GavynDracula/GyreNano/pcb/keyfield-fpc/README.zh-CN.md

# FPC 键区 — V27

[English](README.md)

一款通用半边板，左手 18 键；右手去掉/不装 T_SW1、T_D1，使用 17 键。尺寸 **97.176 × 96.472 mm**，双层 **0.11 mm PI、1/3 oz 铜**，每侧六根键区 FFC，复用现有 holder。

[已提交试样 ZIP](fabrication/GyreNanoKeyfieldFPCV27-SampleED.zip) · [KiCad 工程](kicad/GyreNanoKeyfieldFPCV27.kicad_pro) · [工艺说明](SAMPLE-FABRICATION.txt) · [采购 BOM](BOM.zh-CN.md)

试样采用无胶电解铜、黄色覆盖膜、沉金 1 µin、不做厂家补强。这是用于折弯/装配验证的试样配置，不代表已验证可靠性。JP1 左手只焊 1–2，右手只焊 2–3；不得两侧同时焊接。

此前试样说明中的独立 FR4 背衬方案保留；另有 [FPC 直接承托打印件](../../models/fpc-supports/README.md) 可试验，不能未经检查把两种承托叠加。实际焊接、折弯、热插拔承力和排线安装仍待实物验证。
