GavynDracula/GyreNano/models/integrated-fr4/README.md

# Integrated shells and FR4 retainers

Unchanged V14 upper shells and main retainers; original V8 thumb retainers. All files retain their historical assembly coordinates, in mm. Orient the STL in your slicer; the integrated STL files are not newly bed-oriented. Reuse the [V7 bottom trays](../3x5/).

| Part | Left | Right |
| --- | --- | --- |
| Upper shell | [STL](left-shell.stl) | [STL](right-shell.stl) |
| Main retainer | [STL](left_retainer.stl), [STEP](left_retainer.step) | [STL](right_retainer.stl), [STEP](right_retainer.step) |
| Thumb retainer | [STL](left_thumb_retainer.stl), [STEP](left_thumb_retainer.step) | [STL](right_thumb_retainer.stl), [STEP](right_thumb_retainer.step) |

These mounts/retainers are the existing 0.6 mm FR4 baseline. No 0.4 mm fit adaptation is included. [Static checks](checks/) are retained; no new geometry or slicing was performed during cleanup. The modeled M2 × 4 mm screw/head envelope is a trial assumption, not a qualified fastener selection. Fasten the right thumb retainer before arranging crossing ribbons.

For the bare-FPC route, keep these upper shells and replace all four retainers with [FPC supports](../fpc-supports/README.md).

中文：左右上壳、主区承托、拇指承托按一套选取；这里是原有 0.6 mm FR4 配合，不包含 0.4 mm 改型。STL 为装配坐标，切片时自行摆放，实际螺丝与打印间隙待试装。
