GavynDracula/GyreNano/pcb/keyfield-fr4/alternative-isolated/README.md

# FR4 V32 — retained isolated-region alternative

99.700 × 99.804 mm, two-layer **0.6 mm FR4 / 1 oz**. Five columns plus separate left/right thumb regions have copper-free mechanical joining tabs. There are no cross-region electrical connections.

[KiCad project](kicad/GyreNanoKeyfieldFR4V32.kicad_pro) · [unchanged fabrication ZIP](fabrication/GyreNanoKeyfieldFR4V32-Gerber.zip) · [checks](checks/) · [current V33](../README.md)

This earlier alternative is retained at the user's request. Vendor panel fees/classification and physical forming remain unresolved. Use C0–C4 plus the appropriate thumb region, with six FFCs per hand. Do not confuse this ZIP with V33.

中文版：这是用户要求保留的 V32 备选，区域间没有电路互联，0.6 mm；与 V33 分开放置，避免下单时混淆。材料折弯与实装仍待验证。
