GavynDracula/GyreNano/docs/firmware.md

# Firmware / 固件

TBD. ZMK is the intended firmware. The existing personal configuration has not
been copied into this repository; no ready-to-flash firmware is included.

待补充。采用 ZMK；现有个人配置尚未迁入本仓库，目前没有可直接刷写的固件。
