GavynDracula/GyreNano/docs/images/gyre-nano.png

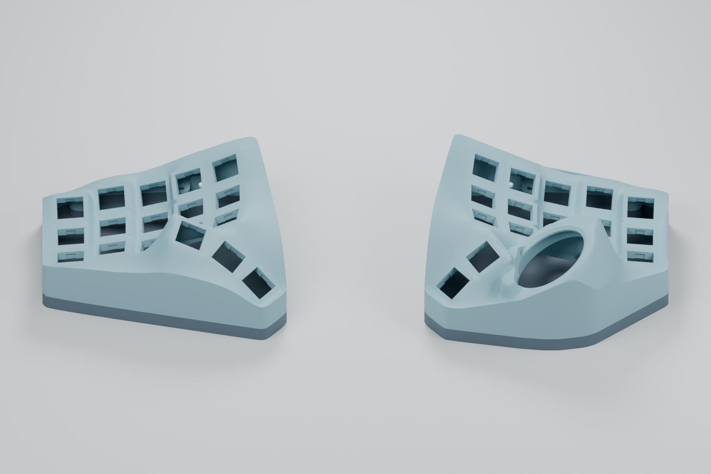
docs/images/gyre-nano.png
