GavynDracula/GyreNano/models/integrated-fr4/images/left-integrated-shell.png

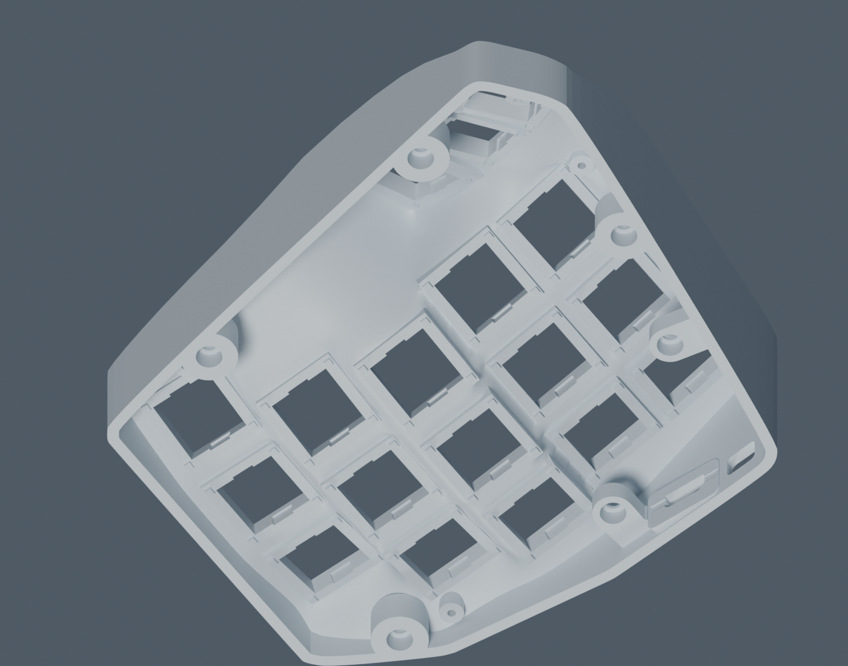
models/integrated-fr4/images/left-integrated-shell.png
