GavynDracula/GyreNano/models/integrated-fr4/images/right-integrated-shell.png

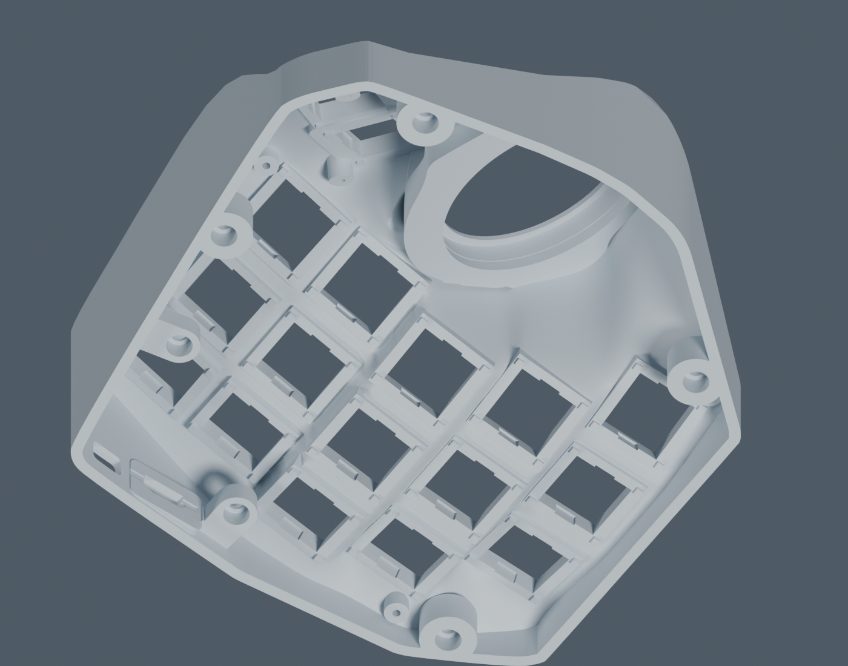
models/integrated-fr4/images/right-integrated-shell.png
