GavynDracula/GyreNano/models/raised-rim/left-transition-detail.png

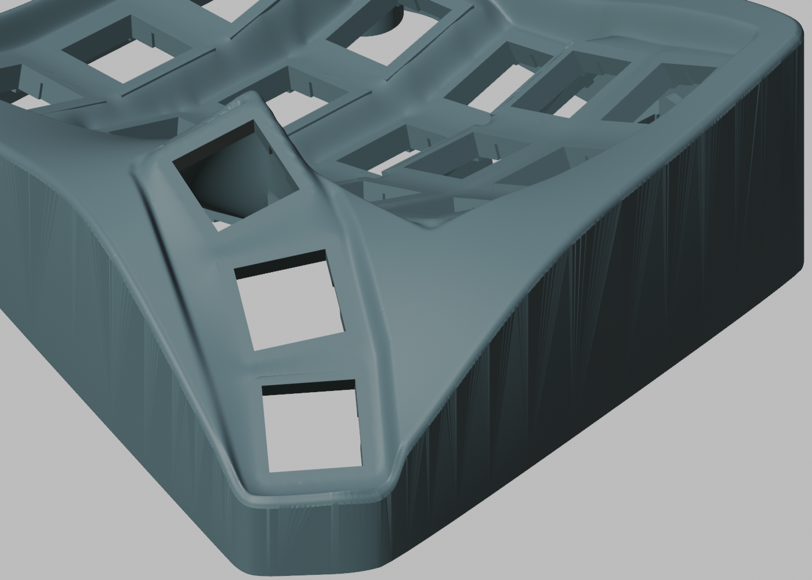
models/raised-rim/left-transition-detail.png
