GavynDracula/GyreNano/models/raised-rim/outer-seam.png

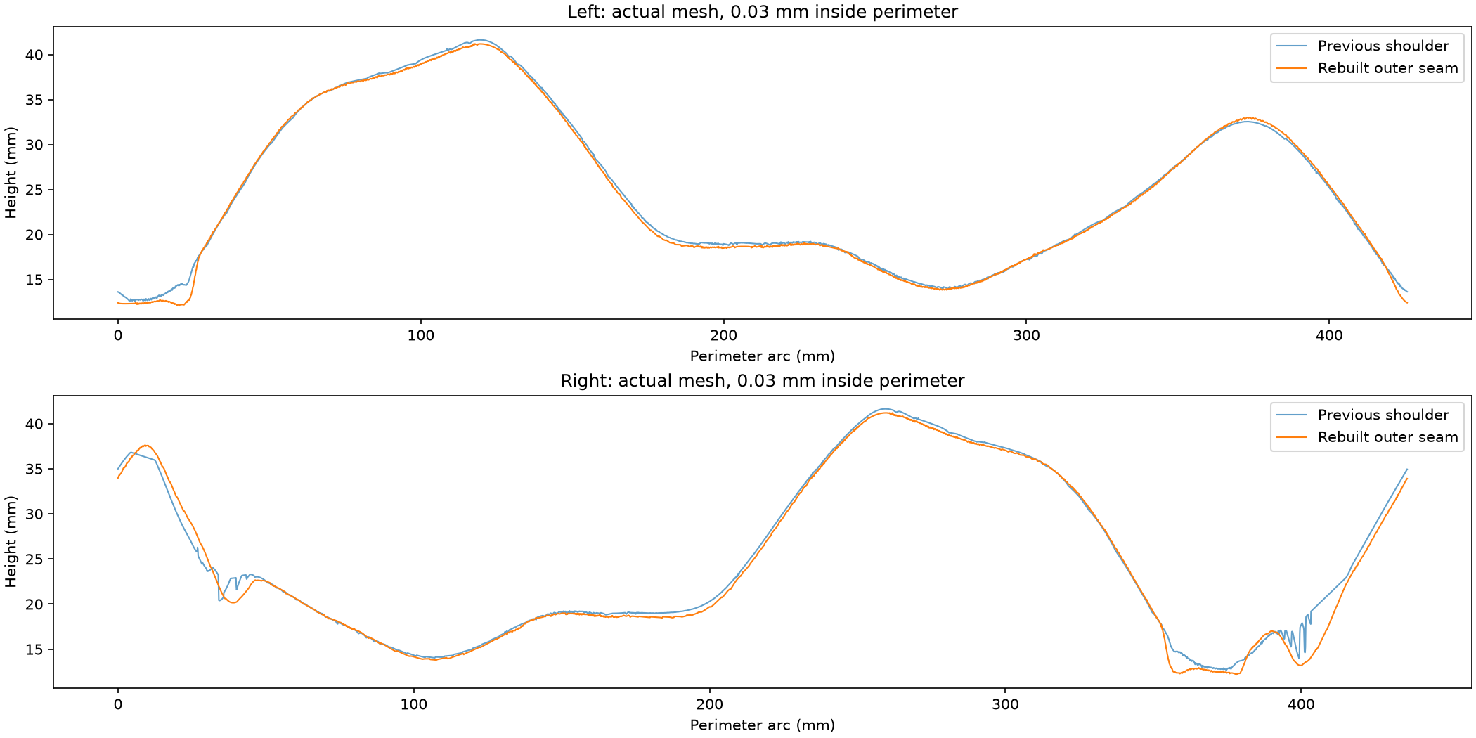
models/raised-rim/outer-seam.png
