GavynDracula/GyreNano/models/raised-rim/right-ball-collar-before.png

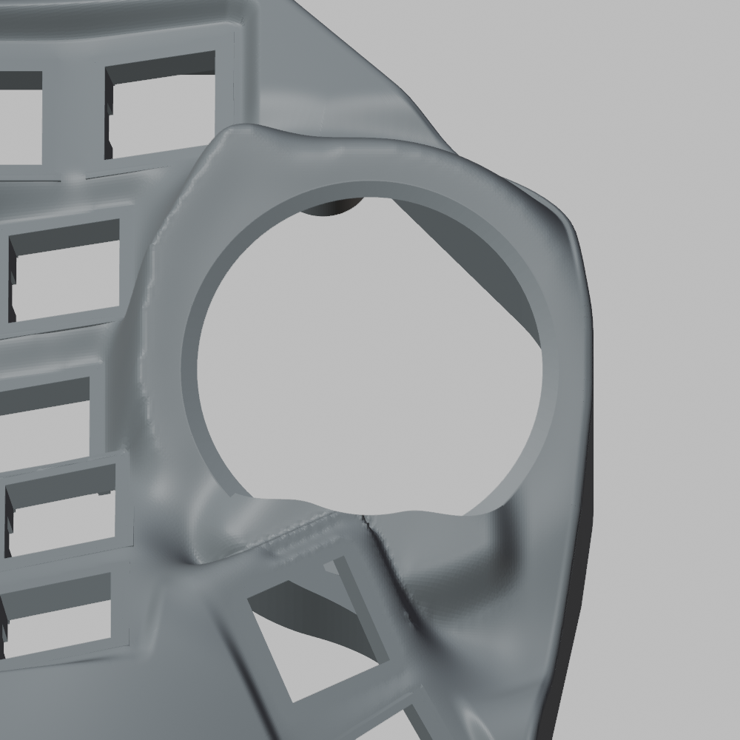
models/raised-rim/right-ball-collar-before.png
