GavynDracula/GyreNano/models/raised-rim/right-outer-seam.png

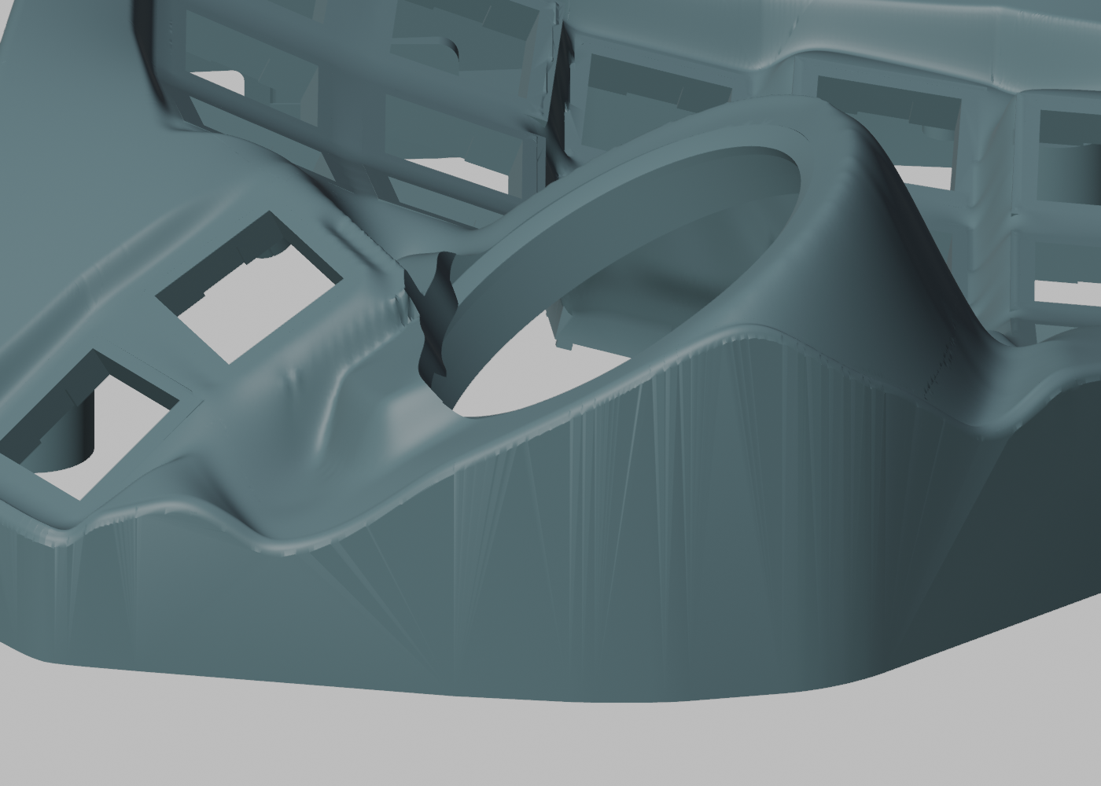
models/raised-rim/right-outer-seam.png
