GavynDracula/GyreNano/models/raised-rim/right-transition-detail.png

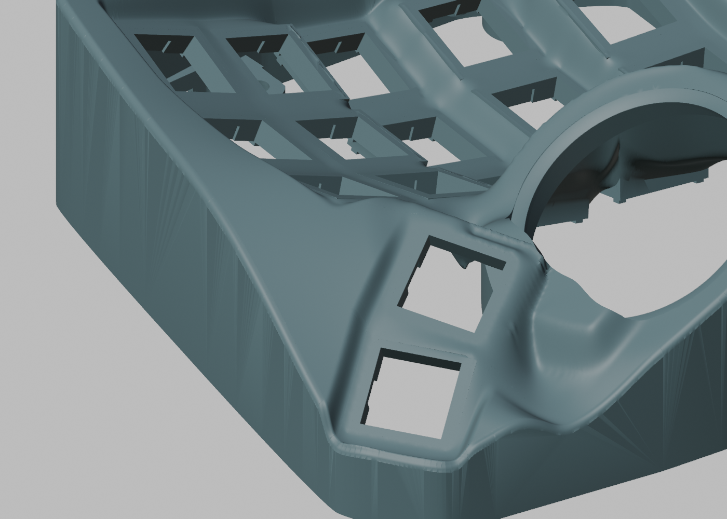
models/raised-rim/right-transition-detail.png
