GavynDracula/GyreNano/models/raised-rim/top.png

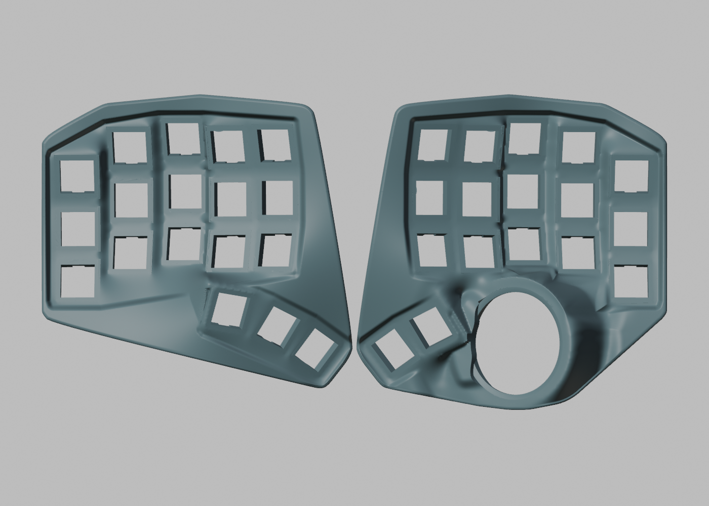
models/raised-rim/top.png
