GavynDracula/GyreNano/models/raised-rim/transition-sections.png

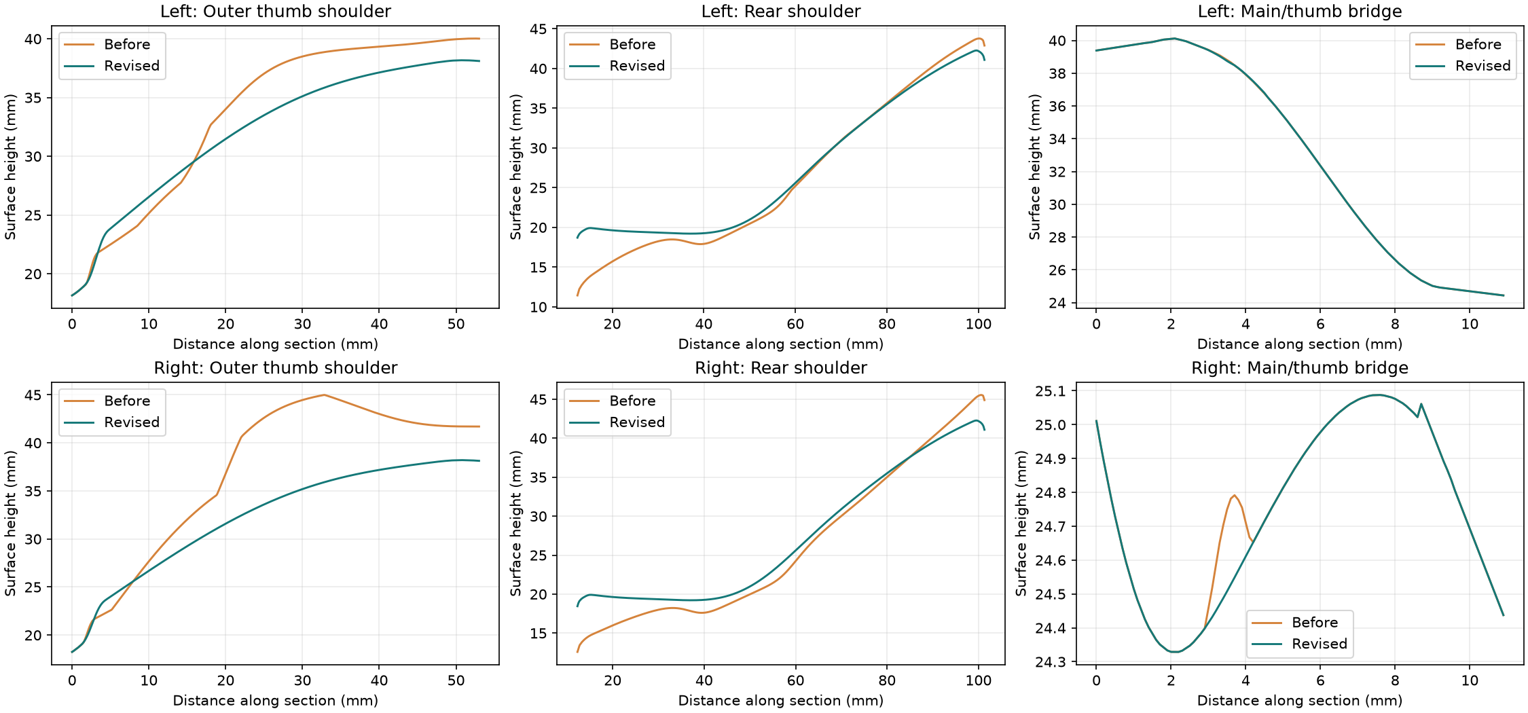
models/raised-rim/transition-sections.png
