GavynDracula/GyreNano/pcb/keyfield-fpc/images/GyreNanoKeyfieldFPCV27-layout.png

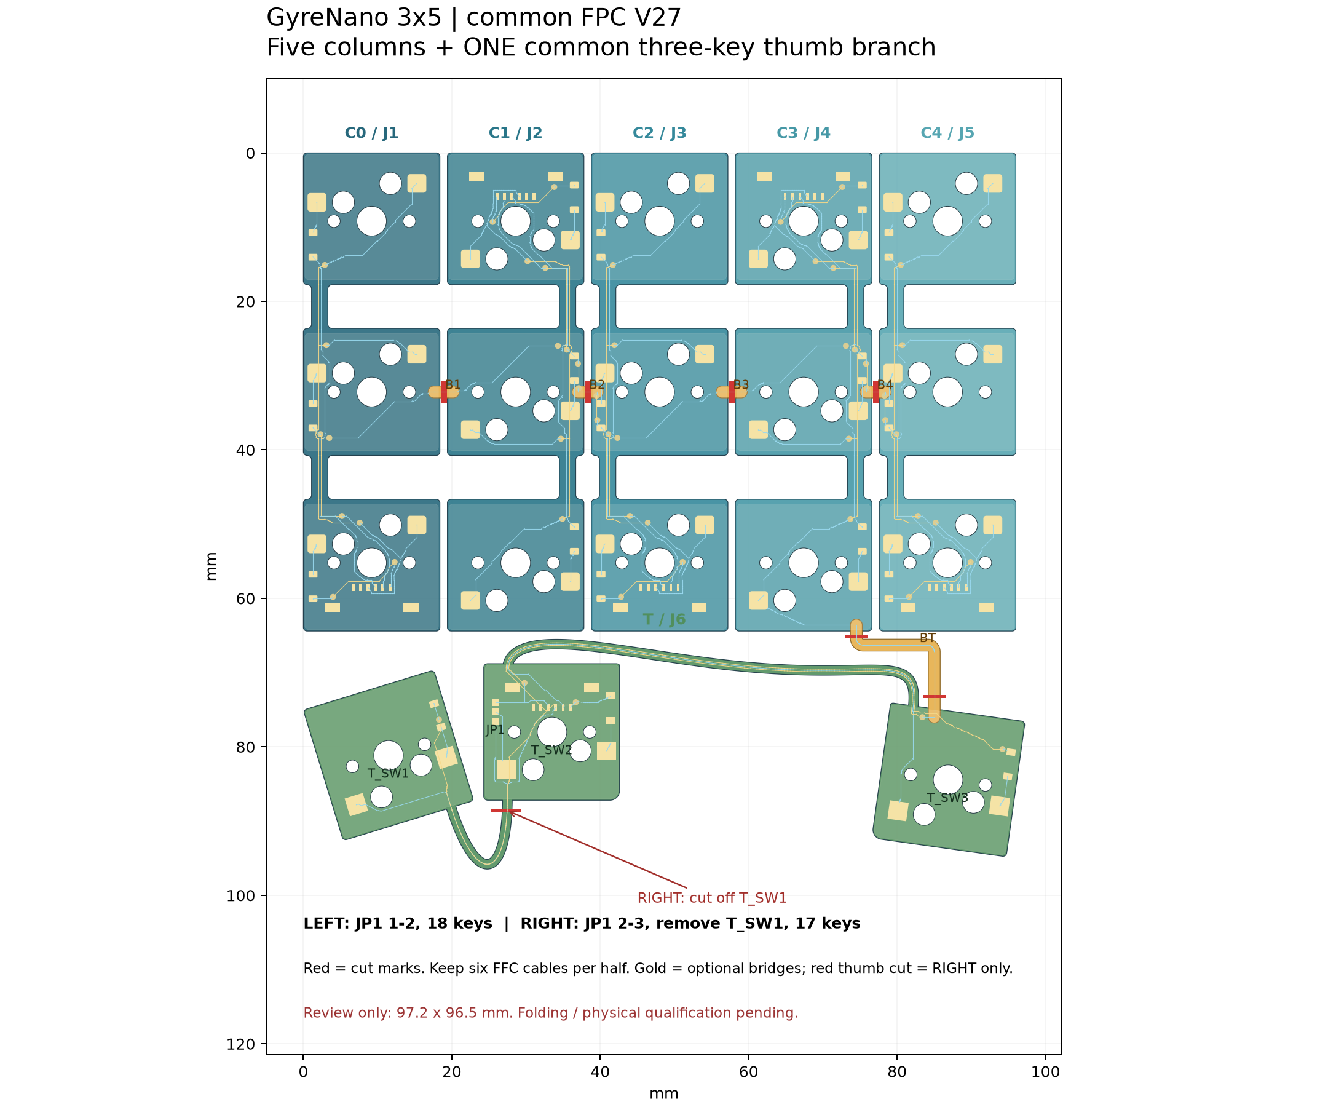
pcb/keyfield-fpc/images/GyreNanoKeyfieldFPCV27-layout.png
