GavynDracula/GyreNano/pcb/keyfield-fpc/images/left-thumb-fold.png

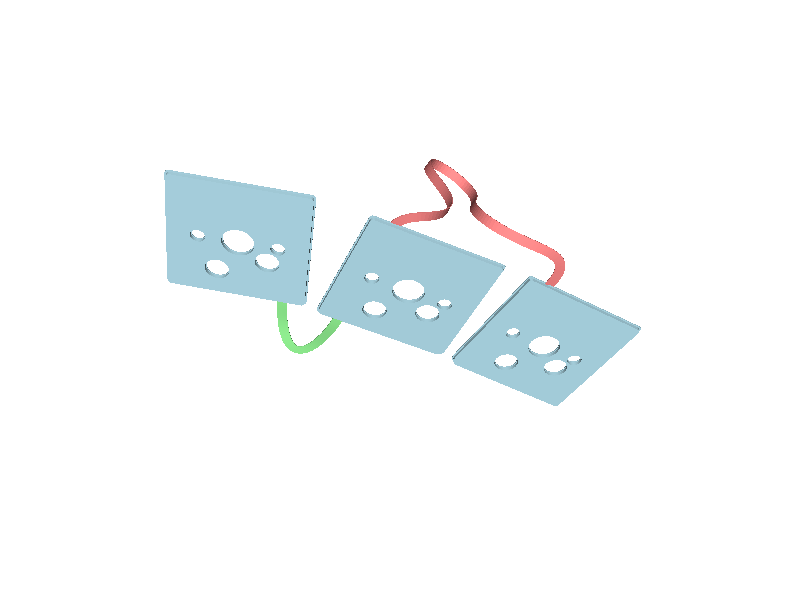
pcb/keyfield-fpc/images/left-thumb-fold.png
