GavynDracula/GyreNano/pcb/keyfield-fpc/images/right-thumb-fold.png

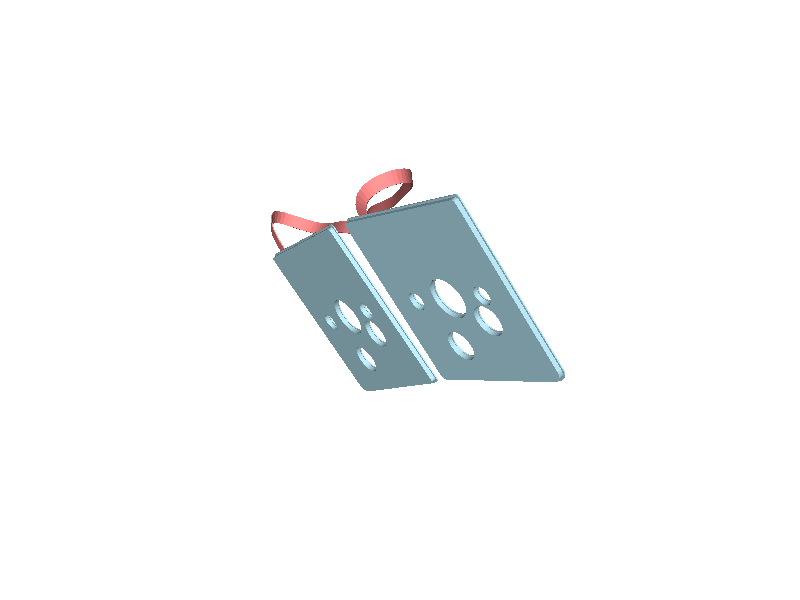
pcb/keyfield-fpc/images/right-thumb-fold.png
