GavynDracula/GyreNano/pcb/keyfield-fr4/eda/preview/GyreNanoKeyfieldEDA.png

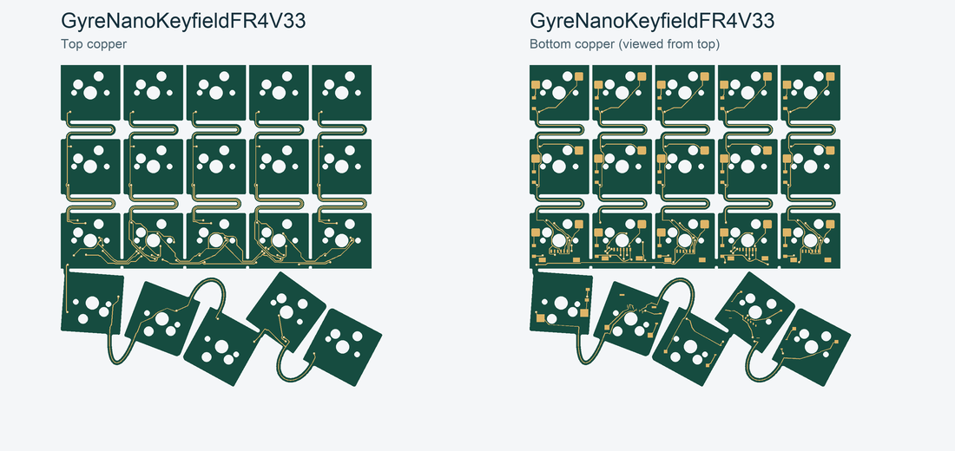
pcb/keyfield-fr4/eda/preview/GyreNanoKeyfieldEDA.png
