GavynDracula/GyreNano/pcb/keyfield-fpc/BOM.zh-CN.md

# GyreNano V27 采购 BOM（2026-11-12）

按**一套左18键＋右17键**计数，不是把此次5张FPC全部焊满。库存尚未知，采购建议是从零备料数量，已有物料自行扣减。用户已提交FPC试样订单，厂家审核结果待定。

来源：V27键区、V12左右holder、V5 sensor原生PCB回读，见[逐件清单及源哈希](checks/bom-native.json)。V22 EDA重建保留这些器件及封装，仅更改开窗/覆铜等；因此对应BOM相同。已打样holder的实际批次尚未回读，本表不代表实物到货检验。推荐采购数量含少量备件；CSV提供“已有/还缺”空栏。

## 先买的核心物料

| 物料 | 型号／规格 | 一套用量 | 建议备料 | 用途 |
|---|---|---:|---:|---|
| MX热插拔座 | Kailh **CPG151101S11-16** | 35 | 40 | 主列30、拇指5；不是Choc轴座 |
| 按键二极管 | **1N4148W-7-F，SOD-123** | 35 | 50或100 | 主列30、拇指5；不要误买SOD-323/直插版 |
| FFC插座 | Molex **2005280060**，6P、1.00mm、卧贴下接触 | 27 | 30 | 两张FPC12＋左右holder14＋新sensor1 |
| 电源拨动开关 | C&K **JS102011SAQN** | 2 | 3 | 每侧holder SW1一个；不要仅按“三脚开关”购买 |
| 电池板端插座 | JST **B2B-PH-SM4-TB**，2P、2.00mm、立式贴片 | 2 | 3 | 两侧holder J8；不是直插PH2.0座 |
| 电池配套线 | PH 2.0、2P配套插头线（PHR-2壳体） | 2 | 2 | 现有电池线若匹配可复用；板端1为正、2为负，实测线序 |

27个FFC插座是完整装配值。左holder J7预留不用，可少焊1个，功能必需26个。若holder已焊好全部插座，则新键区只需12个，另新sensor需1个；复用旧焊线sensor则不装新sensor插座，但需要另做接口转接，不能直接插入旧焊盘。建议保留现用键盘工作状态，优先买新轴座和二极管；反复拆焊旧件可能损伤端子。

FPC原生空板为18轴座＋18二极管＋6插座＋1焊接跳线。右手拆除/不装额外的T_SW1/T_D1后为17键。JP1是PCB焊盘，不买开关、跳线帽或0Ω电阻：左侧只桥接1–2，右侧只桥接2–3，不可同时桥接两边。

## 排线：数量确定，成品采购规格还需试装

共**13根**：左右键区各6根，右侧sensor另1根；左holder J7不用。统一6芯、1.00mm节距，插入端总厚度按Molex图纸 **0.30±0.05mm**；端部露铜、加强片及接点处理也需匹配图纸。不能拿0.11mm键区FPC厚度当成FFC插入端厚度。

目前没有可以无条件照买的13根长度/A-B型清单。V12的[cable-budget.csv](../../docs/cable-budget-reference.csv)是旧路径预算，不是V27实装采购定长；J6整线未定型。可先少量买100/150/250mm的同面与异面样品各1根（共6根）用于辨认接点、测试路径，这些只是试装样品，不保证覆盖整套13根，确认后再补齐。留余长并不意味着任意长线都能收进壳内；不要剪短普通FFC后直接插座使用。

所有键区与sensor要求**板端pin i对应holder pin 7−i**。同面/异面商品的A/B称呼不统一，先按实际插入方向与万用表逐芯确认1↔6、2↔5、3↔4，再接电。插座替代品还需核对焊盘、固定脚、接触面和锁扣占位，不能只按6P/1mm替换。

## 主控与可复用件

| 物料 | 用量 | 采购处理 |
|---|---:|---|
| nrfmicro 1.4 | 2 | 优先复用；nice!nano兼容板不等于全部引脚/电池/充电配置相同，替换前单独核对 |
| 主控排针 | 4条1×12，2.54mm | 两块主控各两排；优先沿用现有安装高度。若用可拔插排母还需4条匹配排母，型号/高度暂不冻结 |
| MX轴、键帽 | 各35 | 复用现有 |
| 电池 | 2 | 复用现有；尺寸/容量尚未记录，不据此推荐新电池 |
| 34mm球、原适配器/轴承/镜片组件 | 各一套 | 复用原配套，保持传感器光学组合 |
| 安装螺丝 | 按现有托架/壳体 | 长度、螺帽及主控堆叠仍需实装，不给未验证的统一长度 |

## 只有重焊新sensor时才采购

现用sensor已经工作正常，可以先保留。若装新FFC sensor板，下表为当前旧版1.9V电路的物料，**不要混用网上bom-fix版的1.8V稳压器/C4值**。旧工程LCSC编号有错配记录，本清单不沿用这些编号；电容按容值、封装、耐压和介质采购。

| 位号 | 规格 | 单板用量 | 建议备料 |
|---|---|---:|---:|
| J1 | Molex 2005280060 | 1 | 已计入上述27个，勿重复加 |
| U2 | PMW3610，匹配当前封装和原光学组件 | 1 | 1，已有可复用；未核准任意模块/裸芯片后缀替代 |
| U1 | Toshiba **TCR2EF19**，1.9V，SOT-25/SMV | 1 | 2 |
| C1、C9 | 10nF，0603公制1608，X7R，≥10V | 2 | 10 |
| C2、C4、C6、C7 | 100nF（0.1µF），0603，X7R，≥10V | 4 | 10 |
| C3 | 3.3µF，0603，16V，X5R/X7R候选 | 1 | 10 |
| C5 | 1µF，0603，X7R，≥10V | 1 | 10 |
| C8 | 10µF，0603，**X7R**，≥6.3V | 1 | 10 |
| R1 | 2MΩ，0603，1% | 1 | 10 |

以上电容耐压/介质中未由源板指定的项是采购候选约束，不是已验证MPN；具体电容应核对直流偏压有效容量与稳压器要求，尤其C3/C8。不要把C8的X7R静默换成Y5V。Sensor VCC接holder规定的电源输出，不直接接电池。新板封装虽与现用旧板兼容，成品板厚与光学堆叠仍需实物确认。

## 背衬与耗材

- **0.40mm无铜绝缘FR4背衬35件**，不是整片FR4粘满FPC。按[背衬DXF](mechanical/GyreNanoV27SeparateFR4Backers.dxf)加工；文件含一个18键空板的18件，做两套共36件，右手多出的1件不用，可多备一套试验。
- 背衬胶层暂按**0.05mm**预算，型号未冻结，先小样验证耐焊接温度、剥离及压合后厚度，避免用厚泡棉胶替代。弯曲细臂不能贴硬背衬。
- 焊锡、助焊剂、吸锡带、耐热平面支撑、放大工具、万用表；已有无需重复买。仅在背衬与托架承托到位后测试插拔轴受力。

## 型号核对来源

- [Molex 2005280060官方规格](https://www.molex.com/en-us/products/part-detail/2005280060)；[端部尺寸图第6页](https://www.molex.com/content/dam/molex/molex-dot-com/products/automated/en-us/salesdrawingpdf/200/200528/2005280040_sd.pdf)。
- [Kailh CPG151101S11-16图纸](https://www.kailhswitch.com/Content/upload/pdf/202215927/CPG151101S11-16.pdf?rnd=109)。
- [C&K JS系列图纸](https://www.ckswitches.com/media/1422/js.pdf)；[JST PH图纸](https://www.jst-mfg.com/product/pdf/eng/ePH.pdf)。
- [Toshiba TCR2EF19官方资料](https://toshiba.semicon-storage.com/eu/semiconductor/product/power-management-ics/low-dropout-regulators-ldo-regulators/detail.TCR2EF19.html)。

2026-11-12核对型号资料；没有承诺库存或价格。当前表格不是嘉立创SMT贴装BOM，不应直接用于自动贴片下单。
