GavynDracula/GyreNano/pcb/keyfield-fpc/BOM.csv

采购类别 | 物料 | 型号或参数 | 封装规格 | 一套用量 | 建议备料数量 | 已有数量 | 还缺数量 | 说明
核心 | MX热插拔座 | Kailh CPG151101S11-16 | MX socket | 35 | 40 |  |  | 主列30+拇指5
核心 | 按键二极管 | 1N4148W-7-F | SOD-123 | 35 | 50或100 |  |  | 不得误买SOD-323
核心 | FFC插座 | Molex 2005280060 | 6P 1mm 下接触 卧贴 | 27 | 30 |  |  | FPC12+holder14+sensor1；左J7可少装1；已焊件扣减
核心 | 电源开关 | C&K JS102011SAQN | SPDT SMT | 2 | 3 |  |  | holder SW1
核心 | 电池板端插座 | JST B2B-PH-SM4-TB | PH2.0 2P立式贴片 | 2 | 3 |  |  | 不是直插座
复用或采购 | 电池插头线 | PHR-2配套线 | PH2.0 2P | 2 | 2或复用 |  |  | 板端1正2负；实测极性
待试装 | FFC排线 | 6芯 1.00mm 插入端0.30±0.05mm | 接点面及长度待定 | 13 | 先小样 |  |  | 12键区+1sensor；可试100/150/250mm同面异面各1，不是定长采购表
复用 | 主控 | nrfmicro 1.4 | 现有模块 | 2 | 优先复用 |  |  | 替代主控需重新核对引脚电源和充电
待试装 | 主控排针 | 1x12 2.54mm | 高度待确认 | 4 | 沿用或4条 |  |  | 可拔插还需4条匹配排母；未冻结堆叠
复用 | 轴体 | 现有MX兼容轴 | MX | 35 | 复用
复用 | 键帽 | 现有键帽 | 匹配现用轴 | 35 | 复用
复用 | 电池 | 现用电池 | 尺寸容量待记录 | 2 | 复用
复用 | 球及光学组件 | 34mm球+原适配器镜片轴承 | 原组合 | 1 | 复用
条件采购：新sensor | 传感器 | PMW3610 | 源板U2封装 | 1 | 1或复用 |  |  | 具体后缀和光学组合需核对；不买任意模块替代
条件采购：新sensor | LDO | TCR2EF19 | SOT-25/SMV 1.9V | 1 | 2 |  |  | U1；不要混用1.8V版
条件采购：新sensor | 电容 C1 C9 | 10nF X7R >=10V | 0603/1608 | 2 | 10 |  |  | 采购候选参数；旧LCSC编号不用
条件采购：新sensor | 电容 C2 C4 C6 C7 | 100nF X7R >=10V | 0603/1608 | 4 | 10 |  |  | C4本版100nF
条件采购：新sensor | 电容 C3 | 3.3uF 16V X5R/X7R候选 | 0603/1608 | 1 | 10 |  |  | 核对有效容量和LDO要求
条件采购：新sensor | 电容 C5 | 1uF X7R >=10V | 0603/1608 | 1 | 10
条件采购：新sensor | 电容 C8 | 10uF X7R >=6.3V | 0603/1608 | 1 | 10 |  |  | 具体MPN待选，核对直流偏压有效容量
条件采购：新sensor | 电阻 R1 | 2Mohm 1% | 0603/1608 | 1 | 10
机械 | 无铜FR4背衬 | 0.40mm 按DXF | 每键独立 | 35 | 做2套18件共36 |  |  | 右侧剩1件；可另备试验件
待验证 | 背衬胶 | 胶层预算0.05mm | 型号未冻结 | 1 | 先小样 |  |  | 胶层耐热厚度和剥离未验证，不直接用厚泡棉胶
