GavynDracula/GyreNano/models/fpc-supports/right_main_support_print.step

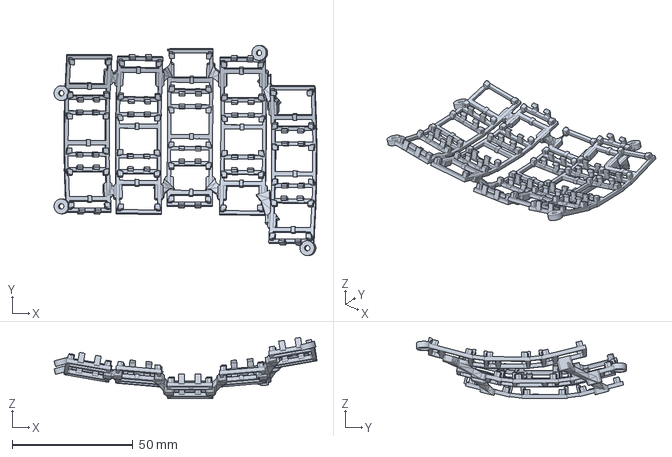
[picture p19: CAD file, 2026-11-13]
models/fpc-supports/right_main_support_print.step
109.0 x 87.1 x 25.4 mm
