GavynDracula/GyreNano/development/references/trackball-top-assembly-v7.stl

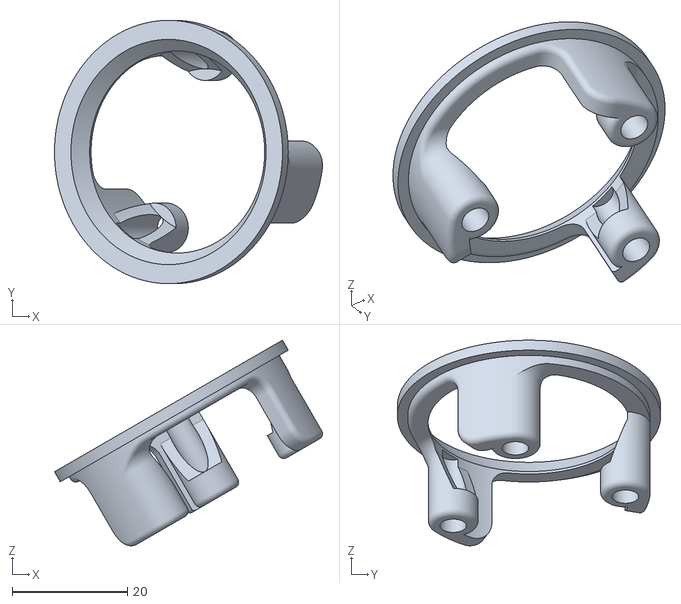
[picture p20: CAD file, 2026-11-10]
development/references/trackball-top-assembly-v7.stl
46.4 x 45.6 x 35.6
