GavynDracula/GyreNano/development/references/trackball-cover-assembly-v7.stl

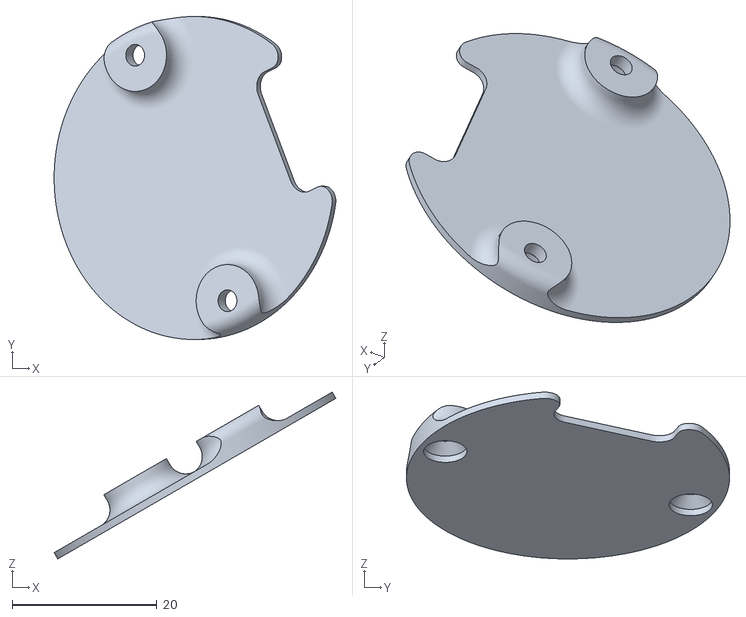
[picture p21: CAD file, 2026-11-10]
development/references/trackball-cover-assembly-v7.stl
39.0 x 44.7 x 23.1
