GavynDracula/GyreNano/development/references/trackball-btu-assembly-v7.stl

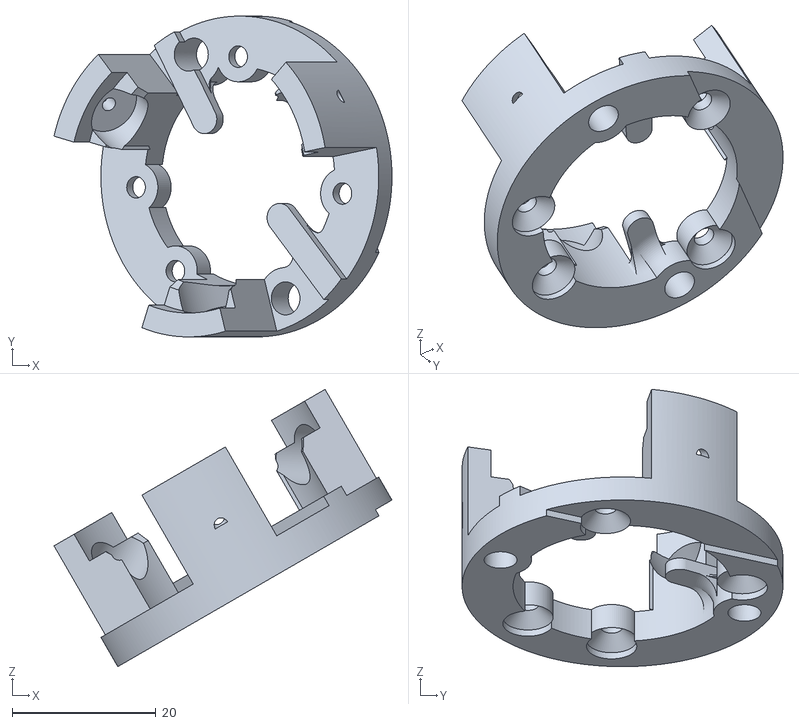
[picture p22: CAD file, 2026-11-10]
development/references/trackball-btu-assembly-v7.stl
47.0 x 44.7 x 38.6
