GavynDracula/GyreNano/development/references/left-upper-features-v7.stl

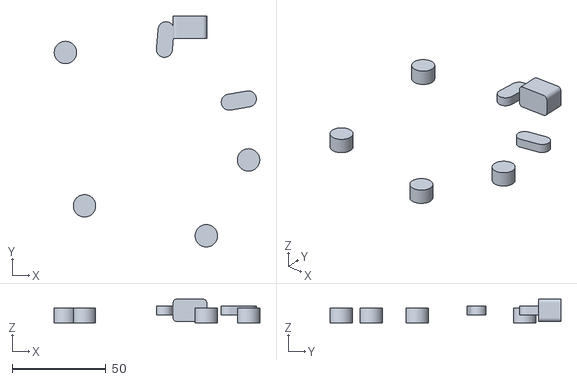
[picture p23: CAD file, 2026-11-10]
development/references/left-upper-features-v7.stl
109.9 x 123.5 x 12.8
