GavynDracula/GyreNano/development/references/regression/ball-opening-v9.stl

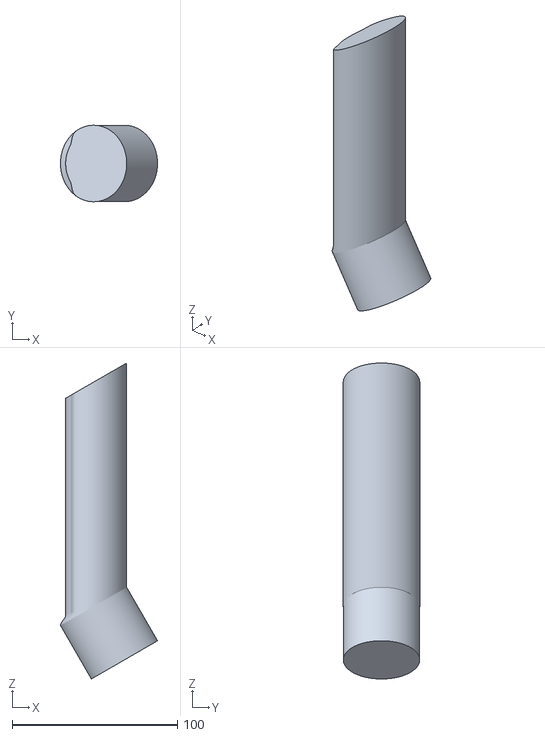
[picture p24: CAD file, 2026-11-10]
development/references/regression/ball-opening-v9.stl
58.8 x 46.3 x 191.3
