GavynDracula/GyreNano/models/3x5/gyre-nano-right-v11.3mf

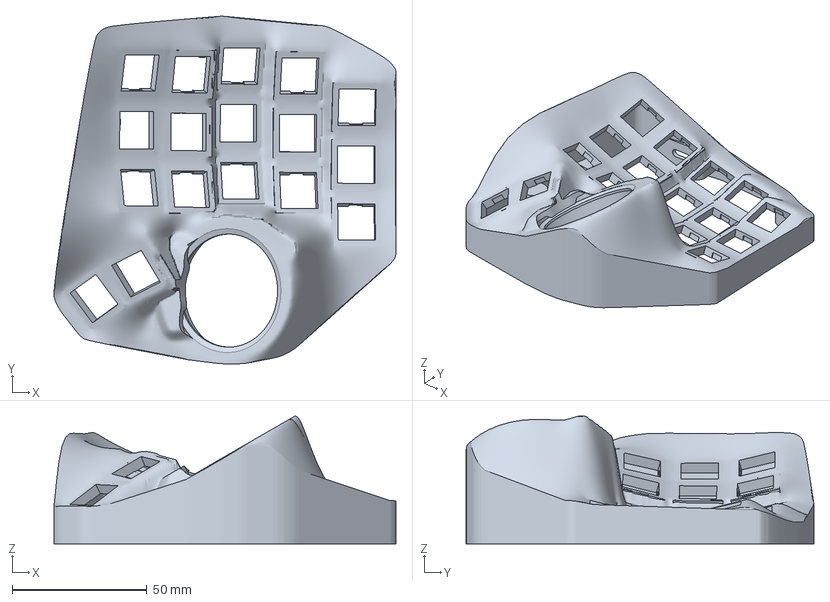
[picture p25: CAD file, 2026-11-10]
models/3x5/gyre-nano-right-v11.3mf
127.1 x 129.2 x 47.5 mm
