GavynDracula/GyreNano/models/integrated-fr4/left_thumb_retainer.step

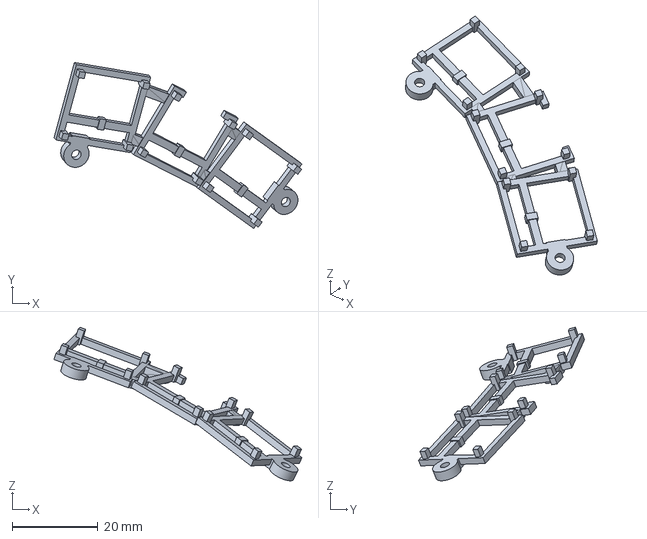
[picture p26: CAD file, 2026-11-13]
models/integrated-fr4/left_thumb_retainer.step
57.9 x 38.7 x 35.9 mm
