GavynDracula/GyreNano/models/raised-rim/GyreNanoLeftShell.3mf

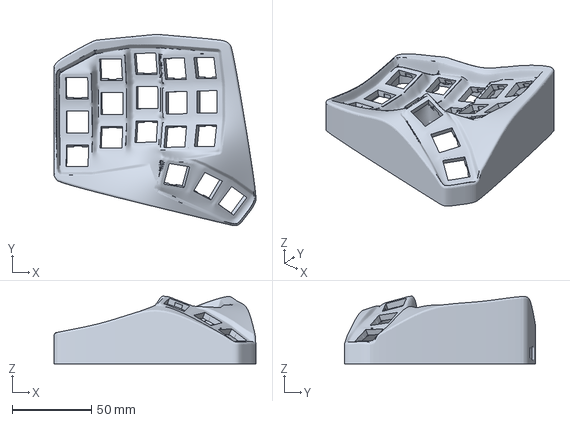
[picture p27: CAD file, 2026-11-13]
models/raised-rim/GyreNanoLeftShell.3mf
127.1 x 120.4 x 42.7 mm
