GavynDracula/GyreNano/models/trials/right-ball-thumb-fit.3mf

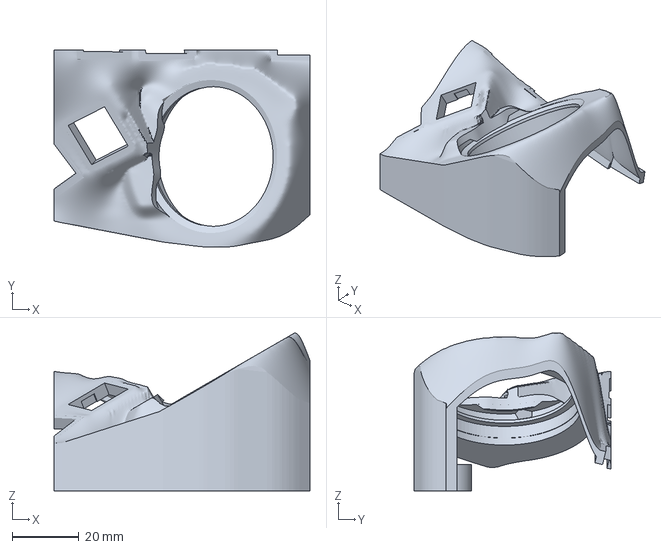
[picture p28: CAD file, 2026-11-10]
models/trials/right-ball-thumb-fit.3mf
77.0 x 59.3 x 47.5 mm
