GavynDracula/GyreNano/pcb/keyfield-fpc/mechanical/GyreNanoV27SeparateFR4Backers.dxf

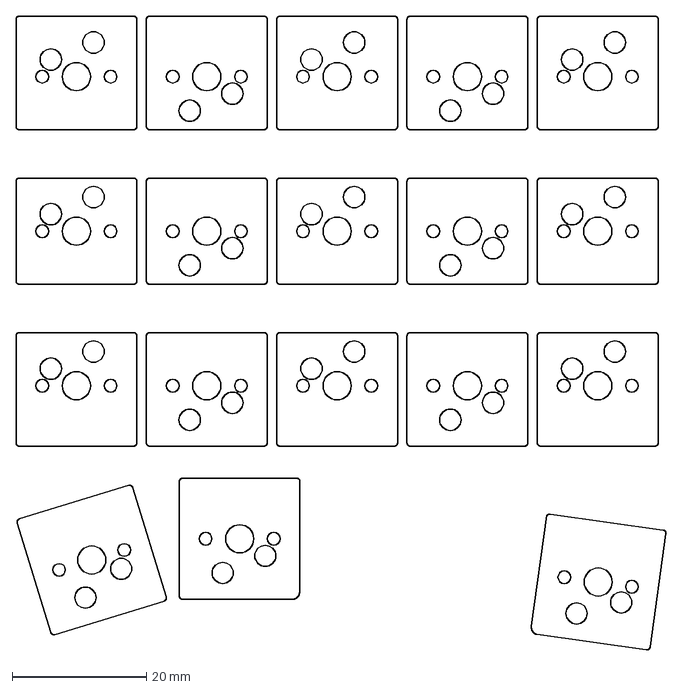
[picture p29: CAD file, 2026-11-13]
pcb/keyfield-fpc/mechanical/GyreNanoV27SeparateFR4Backers.dxf
96.8 x 94.3 mm
