GavynDracula/GyreNano/development/references/right-usb-cut-v7.stl

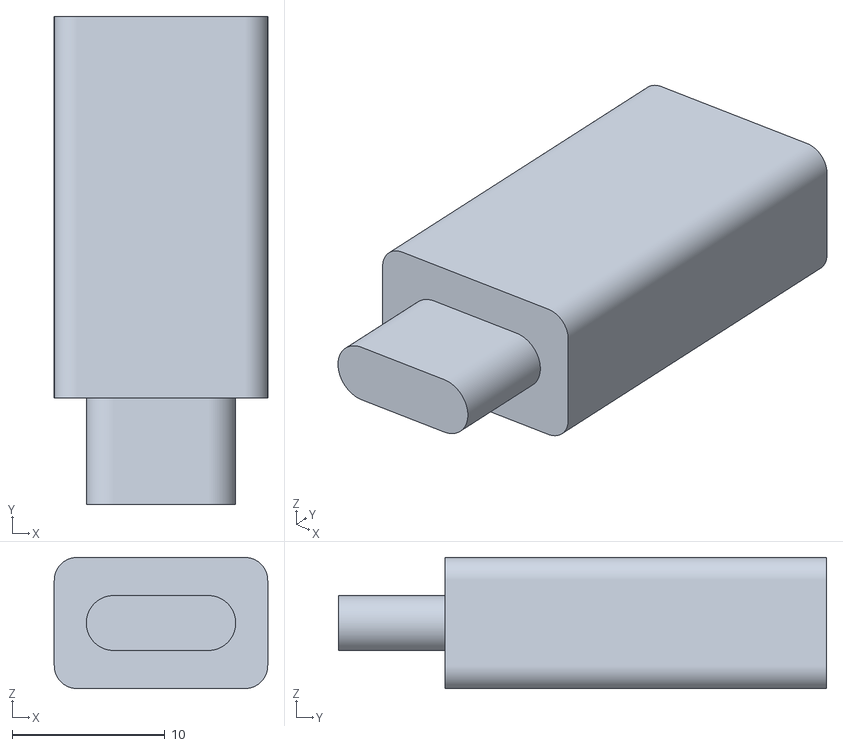
[picture p30: CAD file, 2026-11-10]
development/references/right-usb-cut-v7.stl
14.0 x 32.0 x 8.60
