GavynDracula/GyreNano/models/3x5/gyre-nano-right-bottom-v7.step

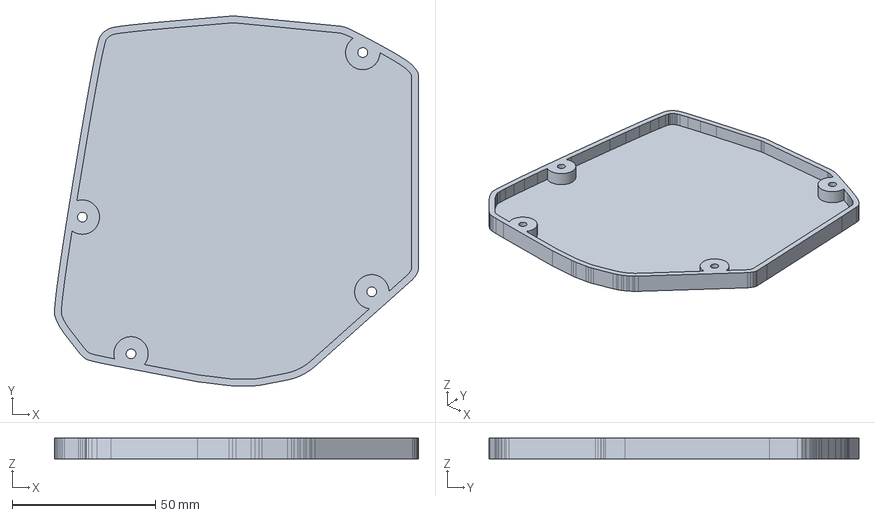
[picture p31: CAD file, 2026-11-10]
models/3x5/gyre-nano-right-bottom-v7.step
127.1 x 129.2 x 7.30 mm
