GavynDracula/GyreNano/models/fpc-supports/right_thumb_support_print.step

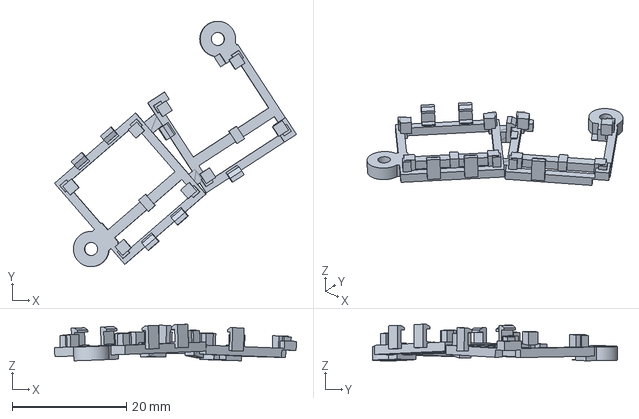
[picture p32: CAD file, 2026-11-13]
models/fpc-supports/right_thumb_support_print.step
42.4 x 43.0 x 6.43 mm
