GavynDracula/GyreNano/models/integrated-fr4/right-shell.stl

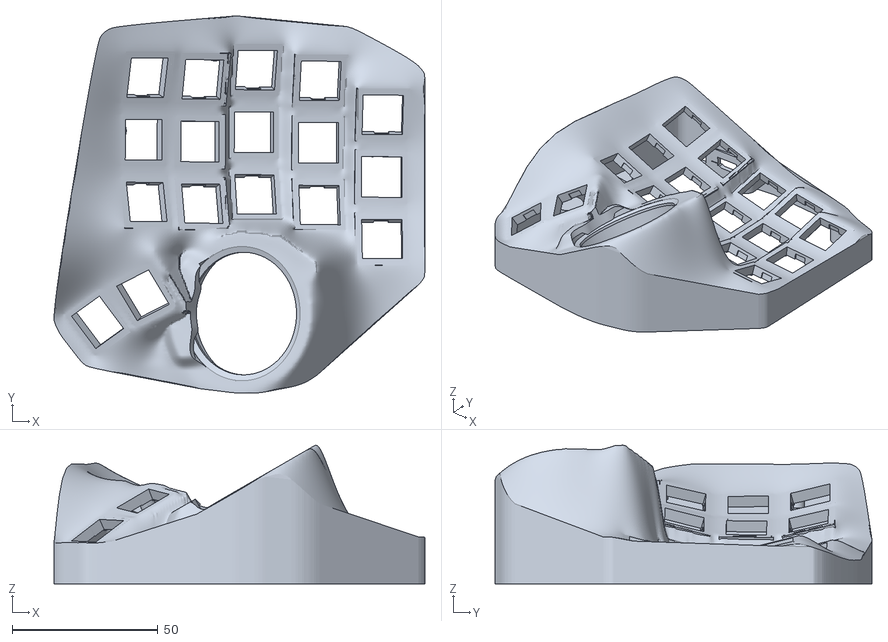
[picture p33: CAD file, 2026-11-13]
models/integrated-fr4/right-shell.stl
127.1 x 129.2 x 47.5
