GavynDracula/GyreNano/models/raised-rim/GyreNanoRightShell.3mf

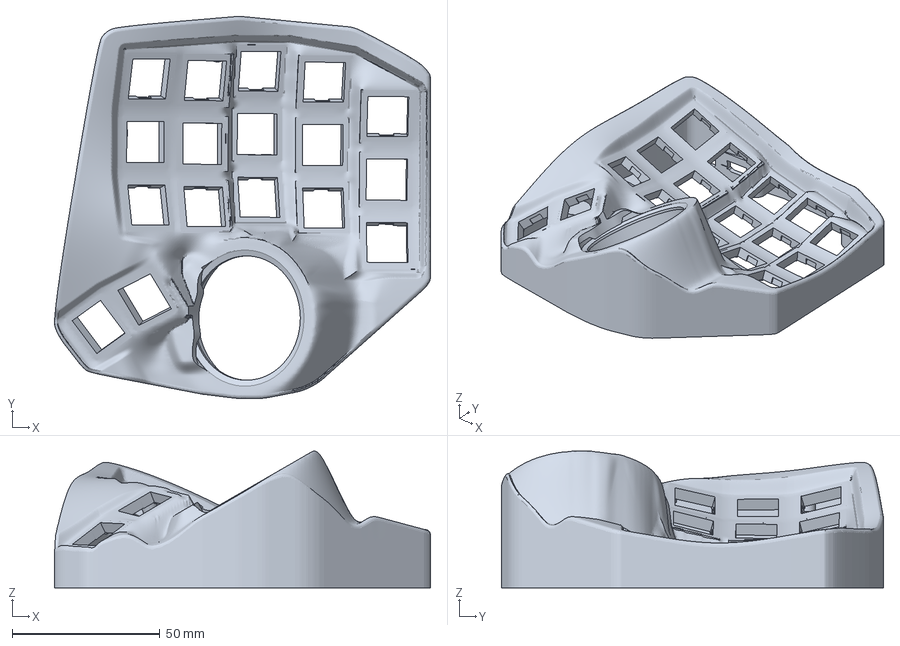
[picture p34: CAD file, 2026-11-13]
models/raised-rim/GyreNanoRightShell.3mf
127.1 x 129.2 x 46.3 mm
