GavynDracula/GyreNano/models/trials/right-holder-usb-fit.3mf

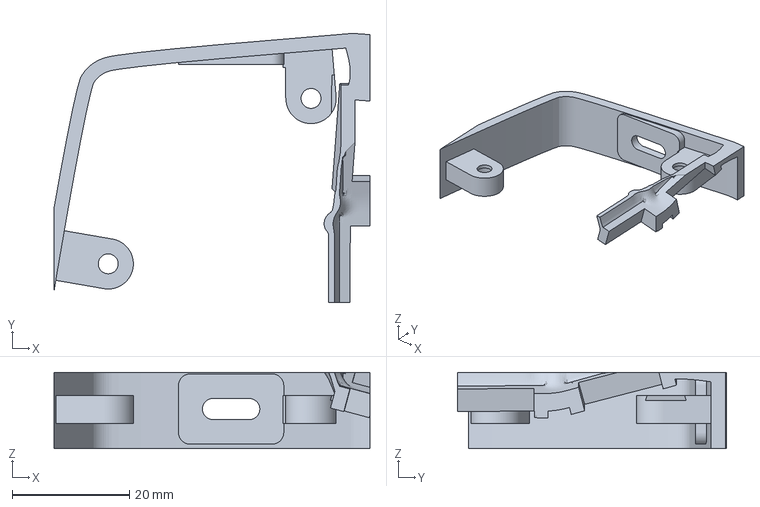
[picture p35: CAD file, 2026-11-10]
models/trials/right-holder-usb-fit.3mf
54.0 x 46.0 x 13.0 mm
