GavynDracula/GyreNano/models/3x5/gyre-nano-left-v7.3mf

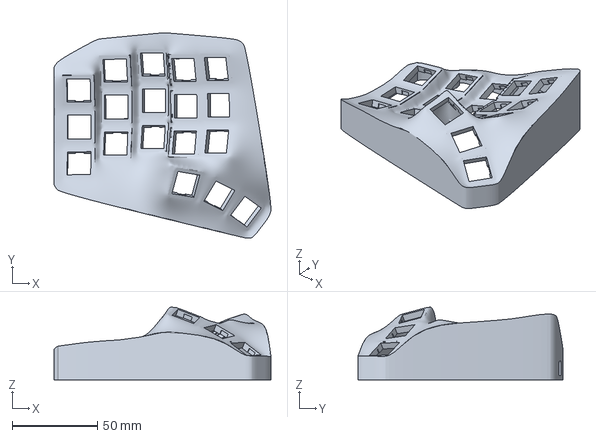
[picture p36: CAD file, 2026-11-10]
models/3x5/gyre-nano-left-v7.3mf
127.1 x 120.4 x 42.7 mm
