GavynDracula/GyreNano/models/fpc-supports/left_thumb_support_print.step

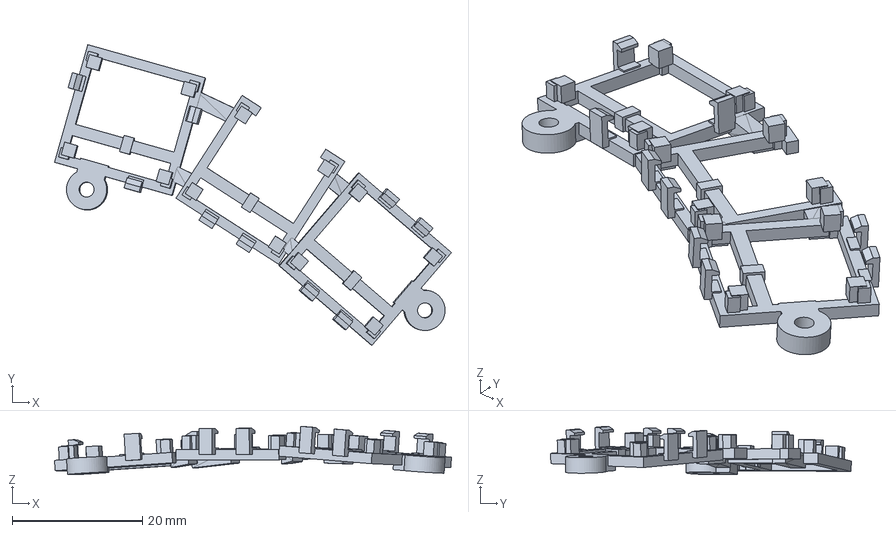
[picture p37: CAD file, 2026-11-13]
models/fpc-supports/left_thumb_support_print.step
61.1 x 46.2 x 7.42 mm
