GavynDracula/GyreNano/models/integrated-fr4/right_retainer.step

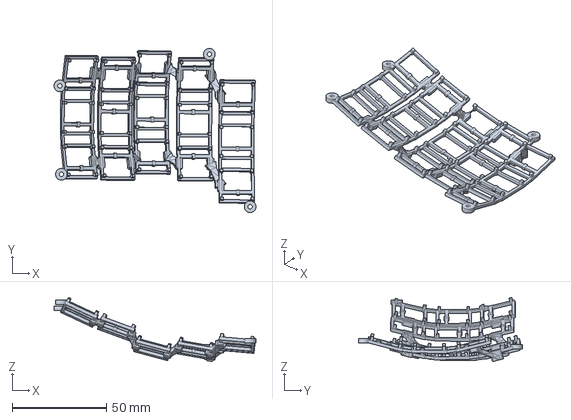
[picture p38: CAD file, 2026-11-13]
models/integrated-fr4/right_retainer.step
107.2 x 87.1 x 34.1 mm
