GavynDracula/GyreNano/development/references/ball-opening-v11.stl

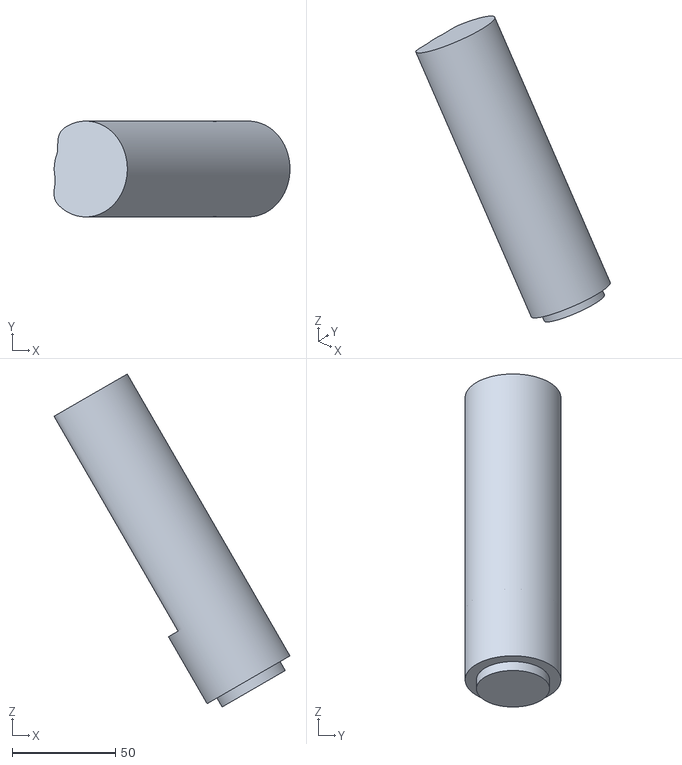
[picture p39: CAD file, 2026-11-10]
development/references/ball-opening-v11.stl
114.1 x 46.3 x 161.0
