GavynDracula/GyreNano/models/3x5/gyre-nano-left-bottom-v7.step

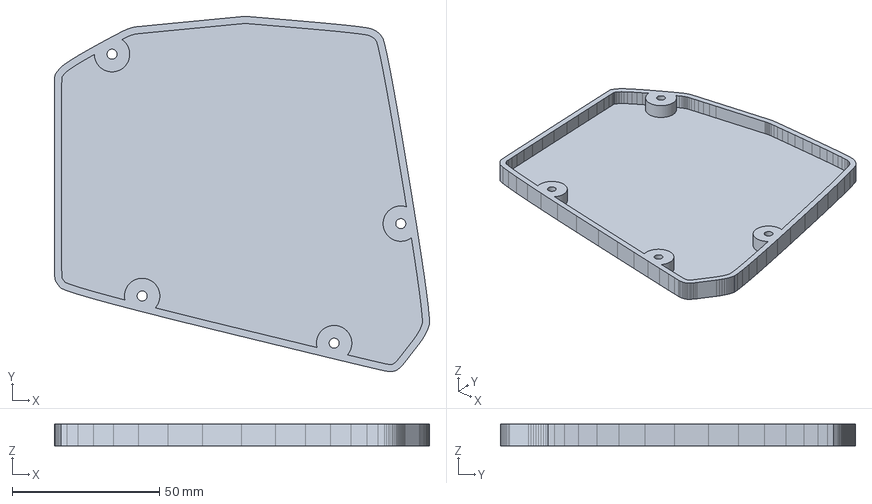
[picture p40: CAD file, 2026-11-10]
models/3x5/gyre-nano-left-bottom-v7.step
127.1 x 120.4 x 7.30 mm
