GavynDracula/GyreNano/models/fpc-supports/coupon_gap_25.3mf

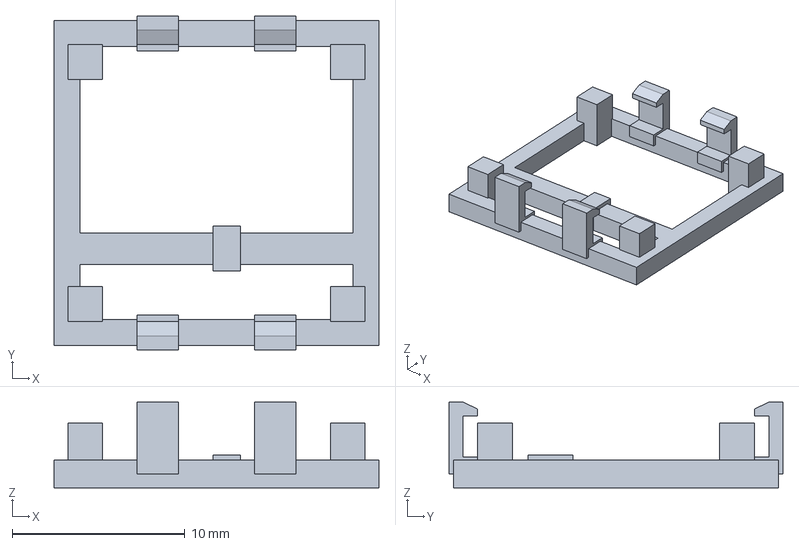
[picture p41: CAD file, 2026-11-13]
models/fpc-supports/coupon_gap_25.3mf
18.8 x 19.3 x 4.96 mm
