GavynDracula/GyreNano/models/integrated-fr4/left-shell.stl

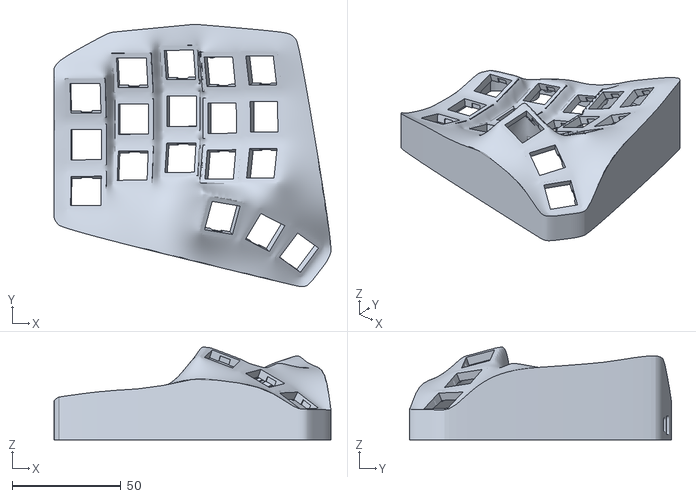
[picture p42: CAD file, 2026-11-13]
models/integrated-fr4/left-shell.stl
127.1 x 120.4 x 42.7
