GavynDracula/GyreNano/development/references/left-holder-support-v7.stl

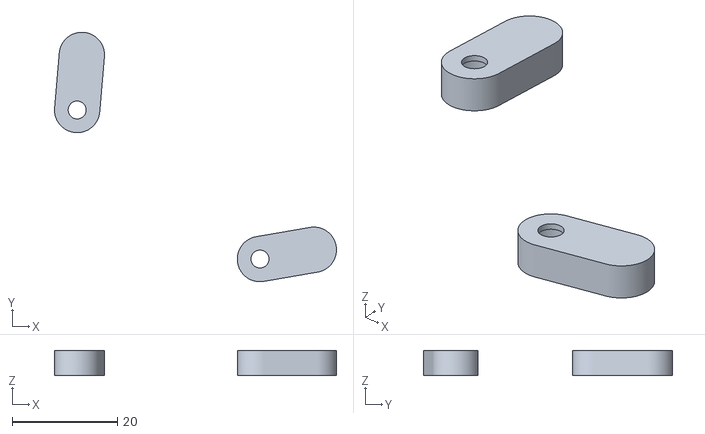
[picture p43: CAD file, 2026-11-10]
development/references/left-holder-support-v7.stl
53.5 x 47.3 x 4.80
