GavynDracula/GyreNano/models/integrated-fr4/right_thumb_retainer.step

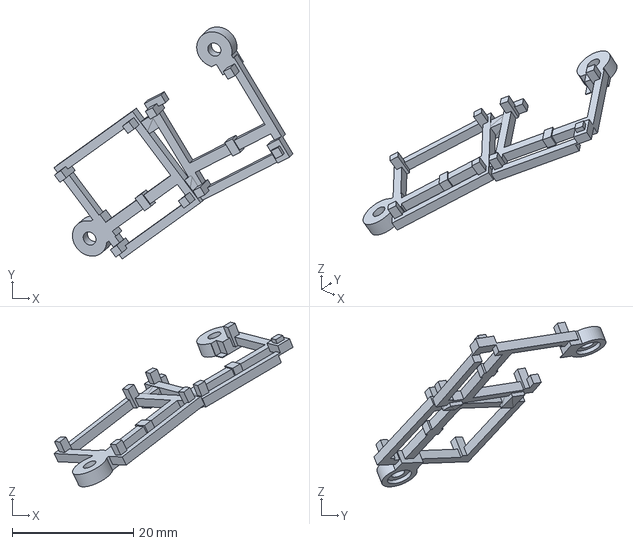
[picture p44: CAD file, 2026-11-13]
models/integrated-fr4/right_thumb_retainer.step
39.4 x 38.3 x 27.2 mm
