GavynDracula/GyreNano/models/fpc-supports/coupon_gap_35.3mf

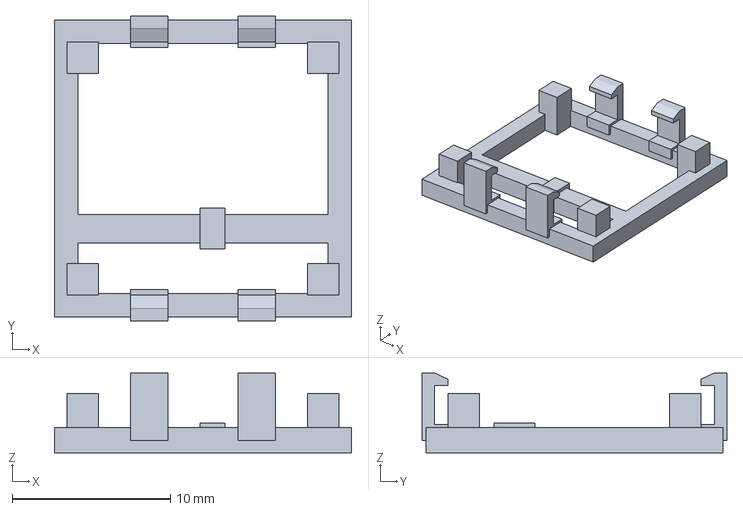
[picture p45: CAD file, 2026-11-13]
models/fpc-supports/coupon_gap_35.3mf
18.8 x 19.3 x 5.06 mm
