GavynDracula/GyreNano/models/fpc-supports/coupon_gap_15.3mf

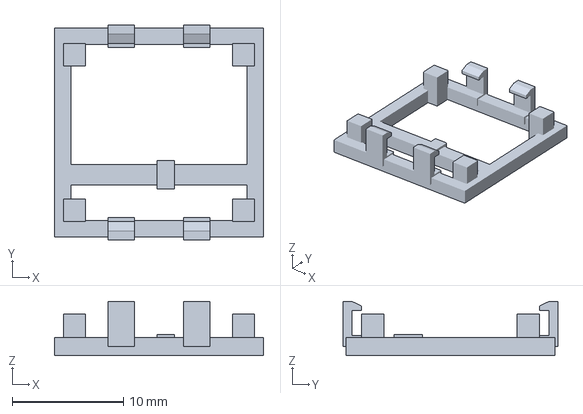
[picture p46: CAD file, 2026-11-13]
models/fpc-supports/coupon_gap_15.3mf
18.8 x 19.3 x 4.86 mm
