GavynDracula/GyreNano/development/references/ball35p2-sweep-v10.step

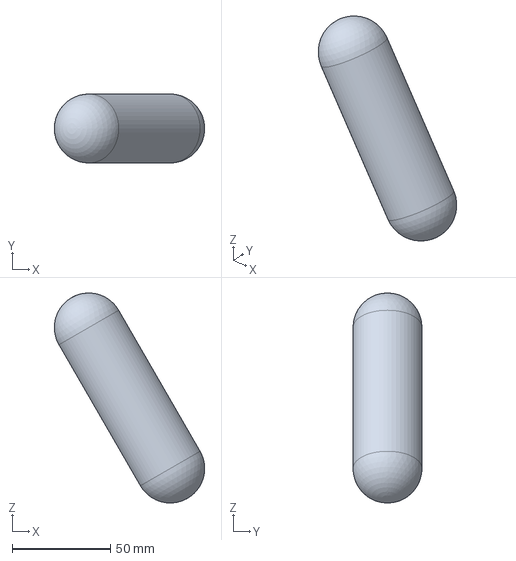
[picture p47: CAD file, 2026-11-10]
development/references/ball35p2-sweep-v10.step
76.7 x 35.2 x 107.0 mm
