GavynDracula/GyreNano/development/references/ball-mount-core.stl

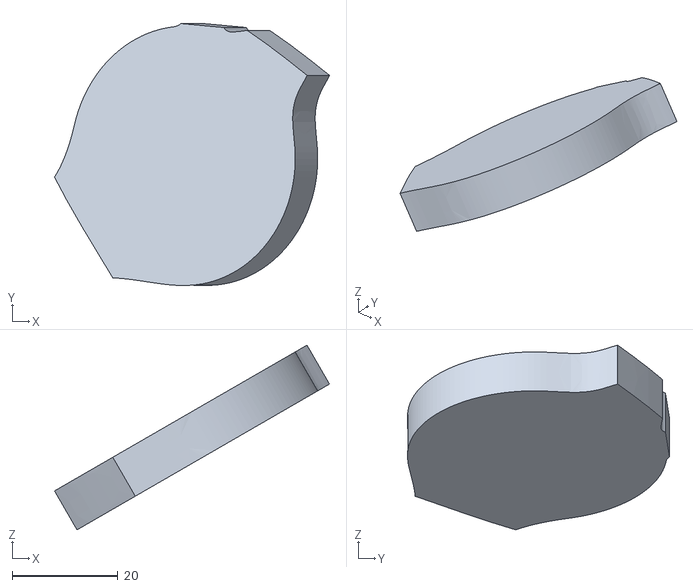
[picture p48: CAD file, 2026-11-10]
development/references/ball-mount-core.stl
52.0 x 49.5 x 34.9
