GavynDracula/GyreNano/development/references/left-interior-v3.stl

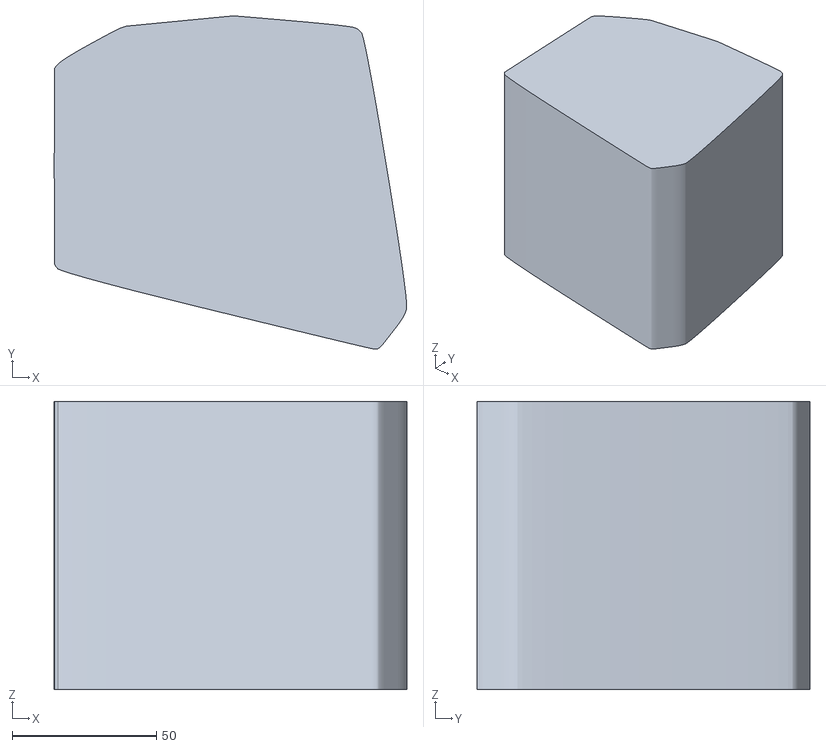
[picture p49: CAD file, 2026-11-10]
development/references/left-interior-v3.stl
122.3 x 115.6 x 100.0
