GavynDracula/GyreNano/development/references/left-holder-pcb-v6.step

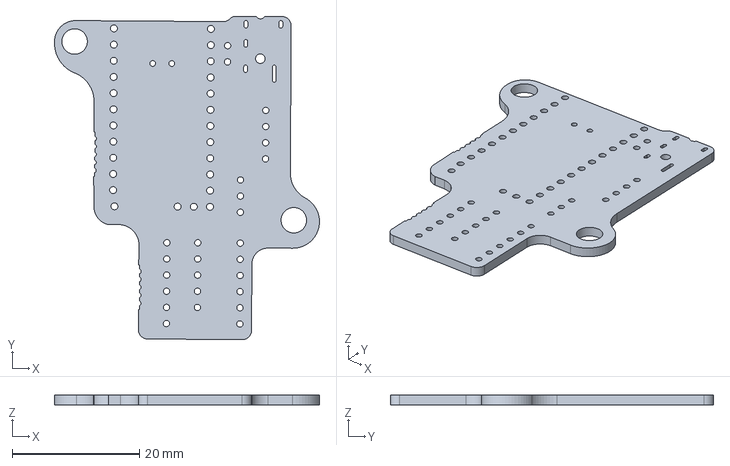
[picture p50: CAD file, 2026-11-10]
development/references/left-holder-pcb-v6.step
41.6 x 50.8 x 1.51 mm
