GavynDracula/GyreNano/development/references/left-mount-bores-v7.stl

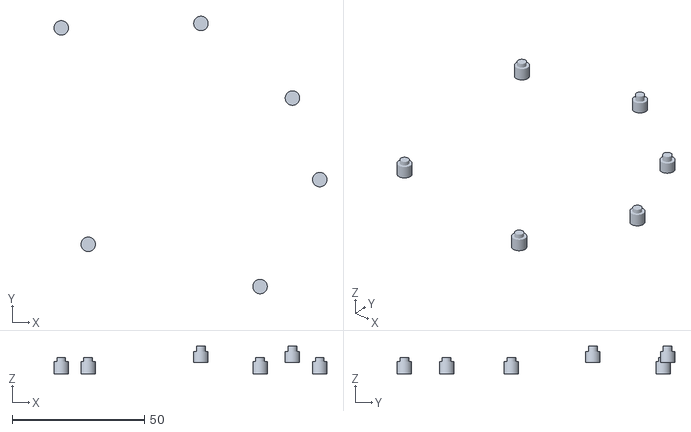
[picture p51: CAD file, 2026-11-10]
development/references/left-mount-bores-v7.stl
103.4 x 105.2 x 10.5
