GavynDracula/GyreNano/development/references/ball34-check-v10.stl

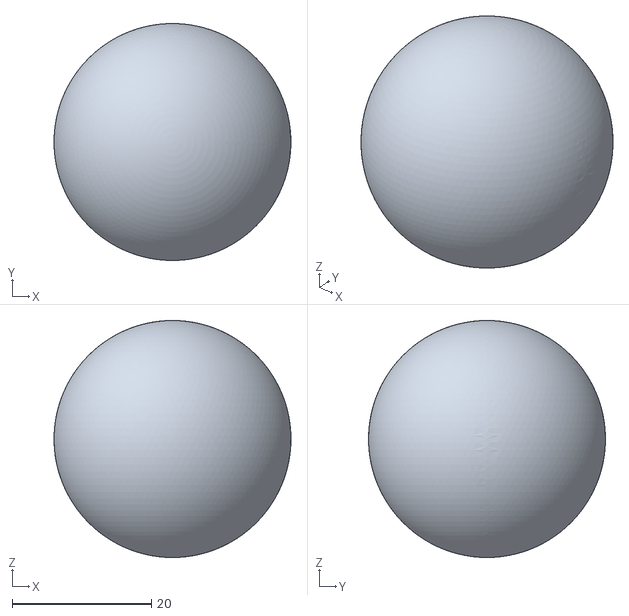
[picture p52: CAD file, 2026-11-10]
development/references/ball34-check-v10.stl
34.0 x 34.0 x 34.0
