GavynDracula/GyreNano/development/references/holder-panel.step

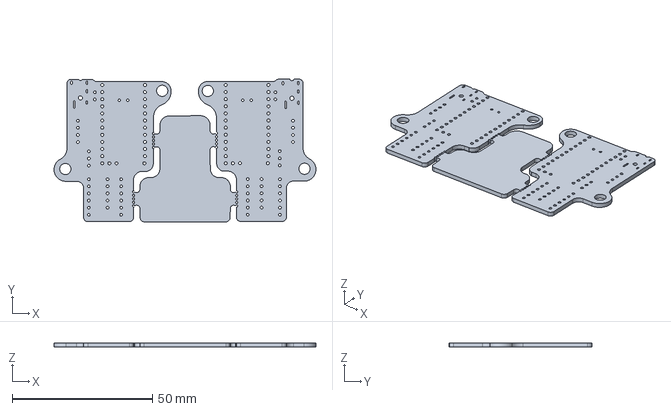
[picture p53: CAD file, 2026-11-10]
development/references/holder-panel.step
93.5 x 50.9 x 1.51 mm
