GavynDracula/GyreNano/development/references/left-usb-plug-envelope-v7.stl

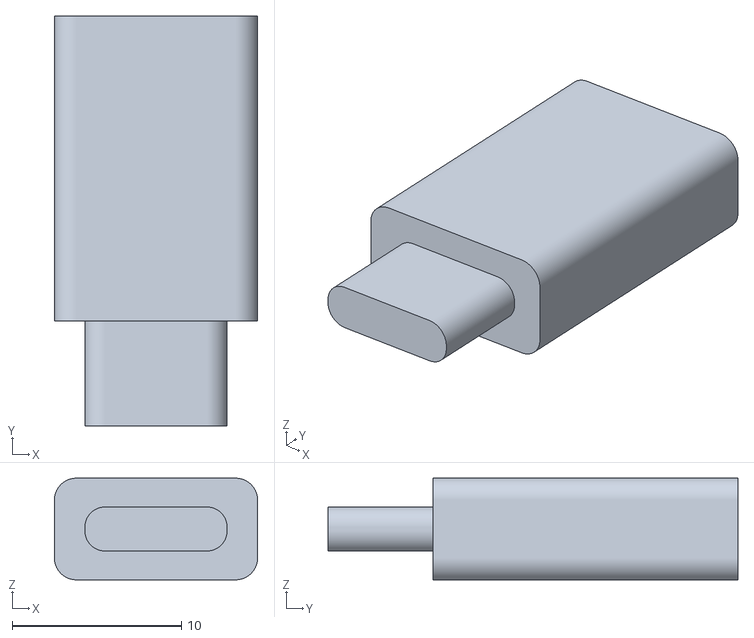
[picture p54: CAD file, 2026-11-10]
development/references/left-usb-plug-envelope-v7.stl
12.0 x 24.2 x 6.00
