GavynDracula/GyreNano/development/references/right-holder-support-v7.stl

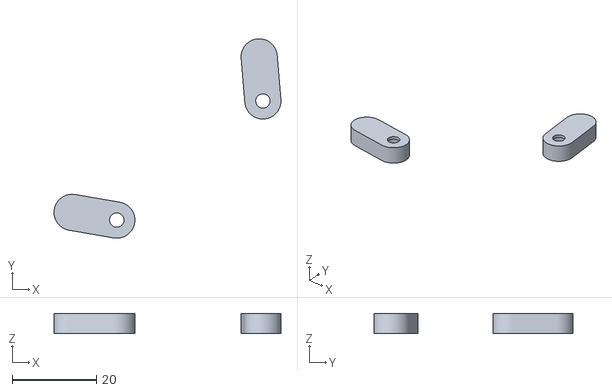
[picture p55: CAD file, 2026-11-10]
development/references/right-holder-support-v7.stl
53.9 x 47.3 x 4.80
