GavynDracula/GyreNano/development/references/right-interior-v3.stl

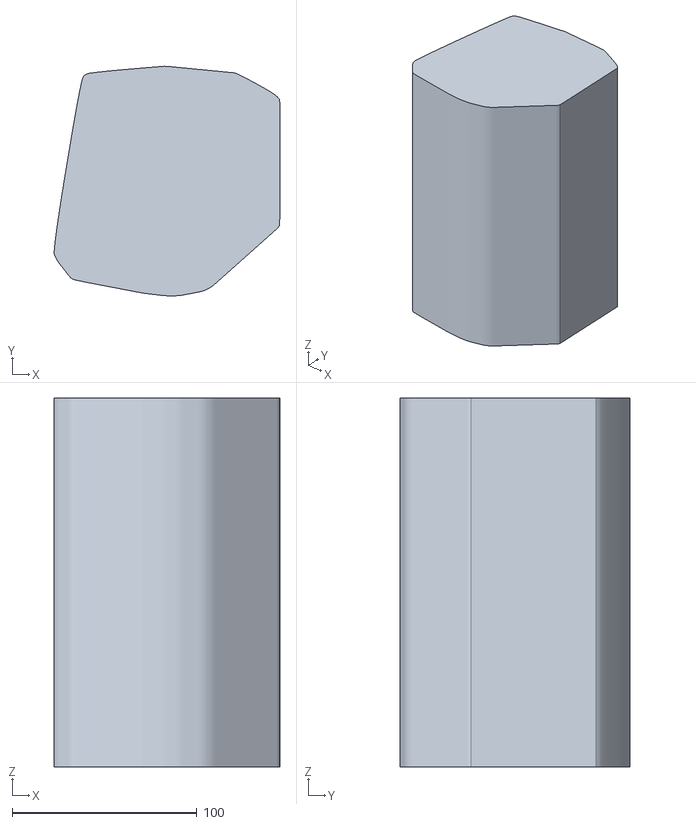
[picture p56: CAD file, 2026-11-10]
development/references/right-interior-v3.stl
122.3 x 124.4 x 200.0
