GavynDracula/GyreNano/development/references/right-mount-bores-v7.stl

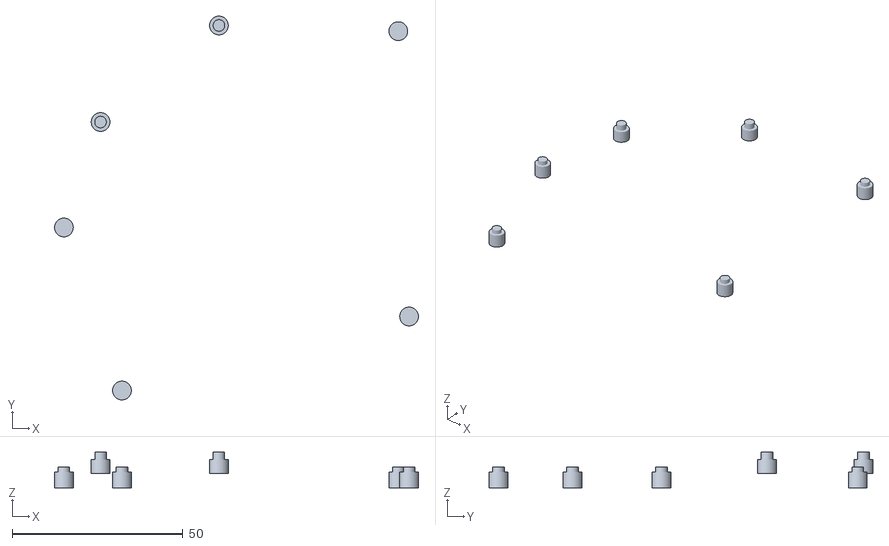
[picture p57: CAD file, 2026-11-10]
development/references/right-mount-bores-v7.stl
106.6 x 112.4 x 10.5
