GavynDracula/GyreNano/development/references/skeletyl-v4-v99.step

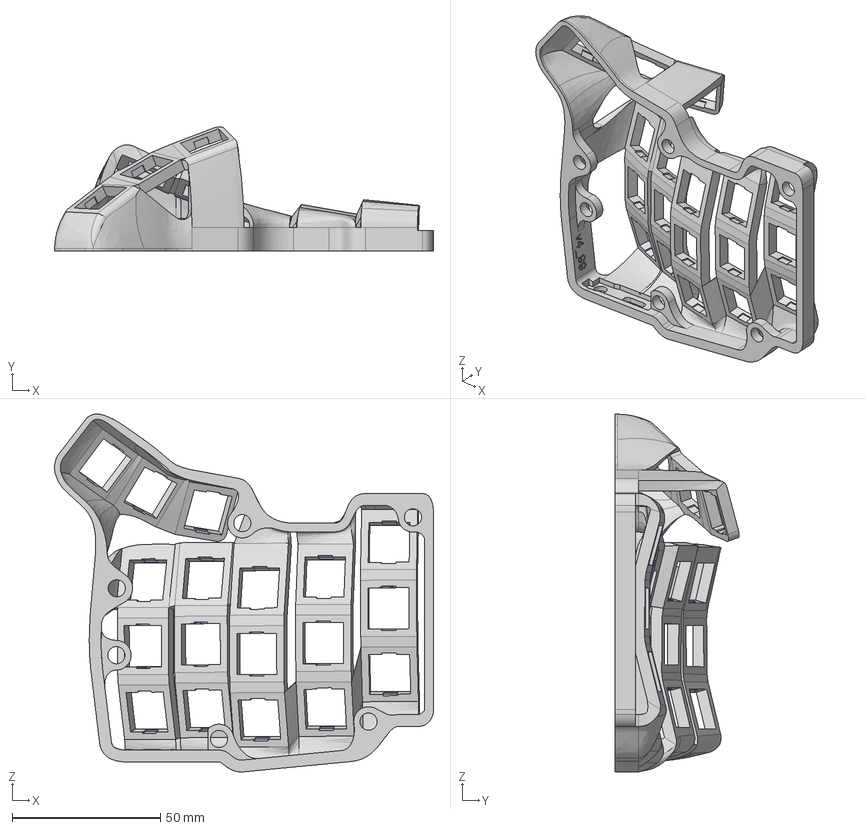
[picture p58: CAD file, 2026-11-10]
development/references/skeletyl-v4-v99.step
128.0 x 42.0 x 120.9 mm
