GavynDracula/GyreNano/development/references/right-upper-features-v7.stl

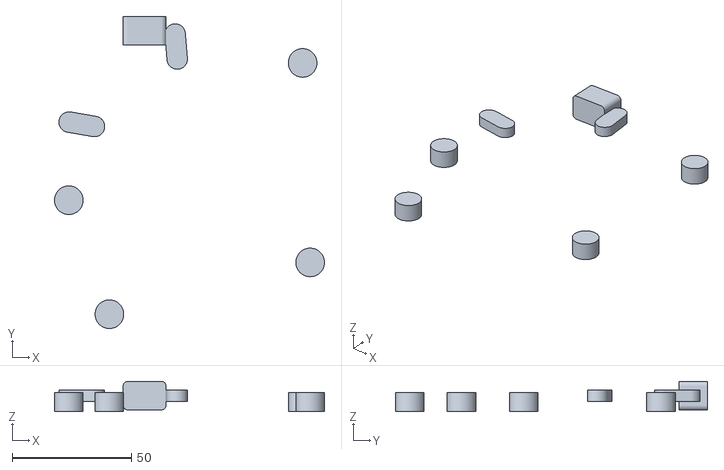
[picture p59: CAD file, 2026-11-10]
development/references/right-upper-features-v7.stl
113.1 x 130.7 x 12.8
