GavynDracula/GyreNano/(list of files, cad)

Other CAD files:
models/fpc-supports/left_main_support_print.step
development/references/left-usb-cut-v7.stl
models/integrated-fr4/left_retainer.step
development/references/right-holder-pcb-v6.step
development/references/right-usb-plug-envelope-v7.stl
development/references/skeletyl-v4-103.stl
development/references/ball35p2-sweep-v10.stl
development/references/holder-panel.stl
development/references/left-holder-pcb-v6.stl
development/references/right-holder-pcb-v6.stl
development/references/right-usb-plug-envelope-v6.stl
models/3x5/gyre-nano-left-bottom-v7.3mf
models/3x5/gyre-nano-right-bottom-v7.3mf
models/fpc-supports/coupon_gap_15.stl
models/fpc-supports/coupon_gap_25.stl
models/fpc-supports/coupon_gap_35.stl
models/fpc-supports/left_main_support_print.3mf
models/fpc-supports/left_main_support_print.stl
models/fpc-supports/left_thumb_support_print.3mf
models/fpc-supports/left_thumb_support_print.stl
models/fpc-supports/right_main_support_print.3mf
models/fpc-supports/right_main_support_print.stl
models/fpc-supports/right_thumb_support_print.3mf
models/fpc-supports/right_thumb_support_print.stl
models/integrated-fr4/left_retainer.stl
models/integrated-fr4/left_thumb_retainer.stl
models/integrated-fr4/right_retainer.stl
models/integrated-fr4/right_thumb_retainer.stl
