GavynDracula/GyreNano/docs/build-guide.md

# Build guide / 装配指南

TBD after physical trial fitting. The enclosure snapshot is available for fit
trials; a complete wiring and assembly sequence is not yet documented.

实物试装后补充。目前提供外壳试打文件，完整接线及装配顺序尚未整理。

- [Print files / 打印文件](../models/)
- [Printing notes](printing.md) / [中文打印说明](FDM-PRINTING.md)
- [Selected electronics / 已选电子元件](BOM.md)
- [Geometry verification / 几何校验](geometry.md)
