GavynDracula/GyreNano/models/fpc-supports/images/print-orientation.png

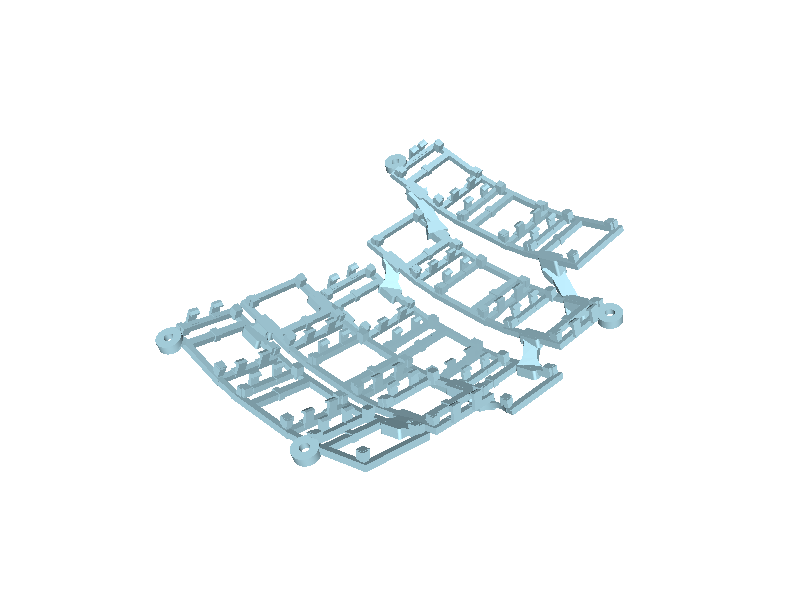
models/fpc-supports/images/print-orientation.png
