GavynDracula/GyreNano/models/integrated-fr4/images/left-retainers-installed.png

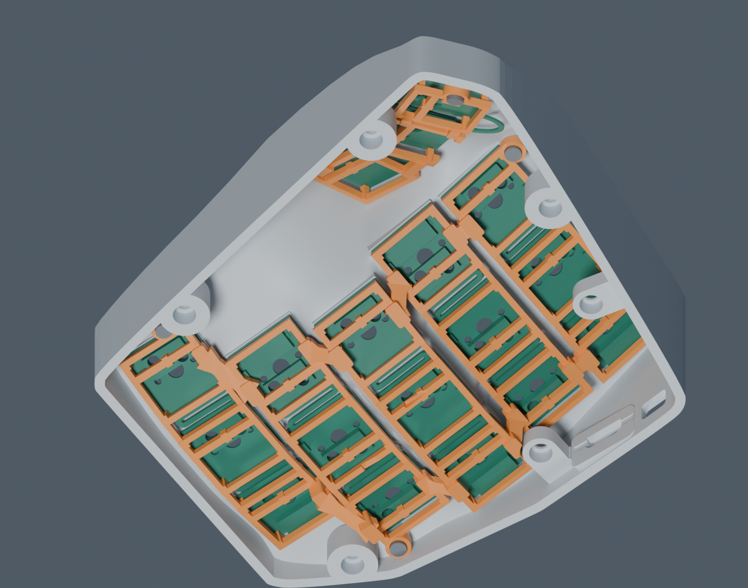
models/integrated-fr4/images/left-retainers-installed.png
