GavynDracula/GyreNano/models/integrated-fr4/images/right-retainers-installed.png

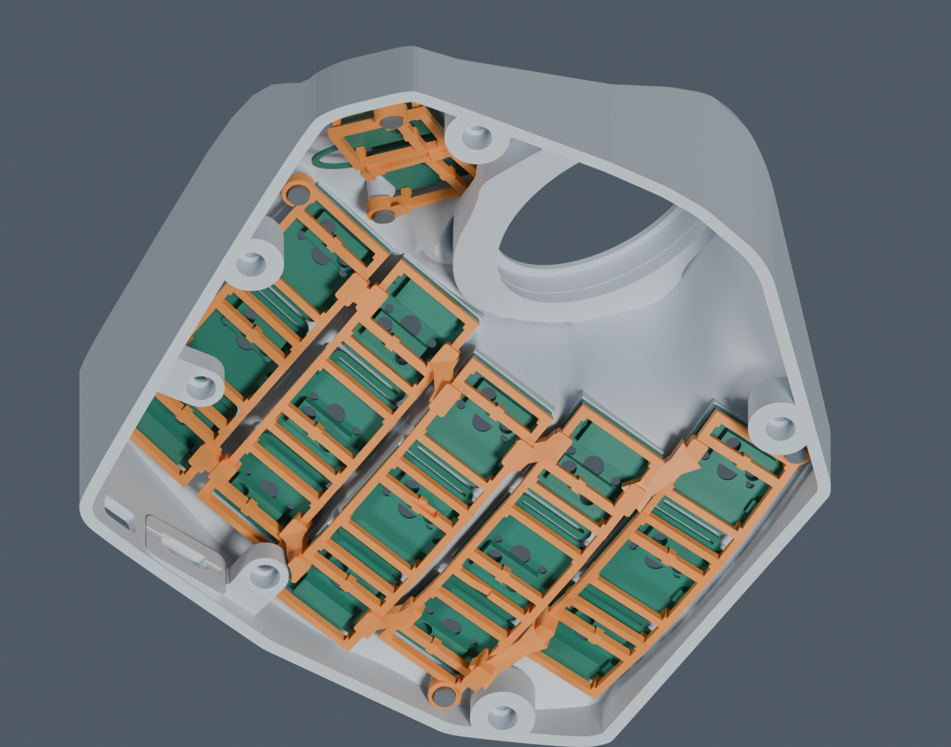
models/integrated-fr4/images/right-retainers-installed.png
