GavynDracula/GyreNano/pcb/eda-validation/README.zh-CN.md

# EDA 重建核验记录

[详细核验与有意变更](README.md)

左右 holder 与 sensor 的原生 EDA V22 工程分别位于 [holders](../holders/README.md) 与 [sensor](../sensor/README.md)。保留原始检查报告，包含引脚网络、保存重开、孔位板框和 CAM 对照；报告内部旧路径属于当时的证据记录。

EDA 版补齐原 KiCad 中缺失的通孔阻焊开窗，sensor 增加安装孔地铜避让。原 KiCad 版作为参考保留，未将修正反向写入。三板当时原理图/PCB DRC 为零；本轮只是整理文件，不宣称新增实物验证或优惠券资格。
