GavynDracula/GyreNano/pcb/keyfield-fpc/images/assembly-reference.pdf

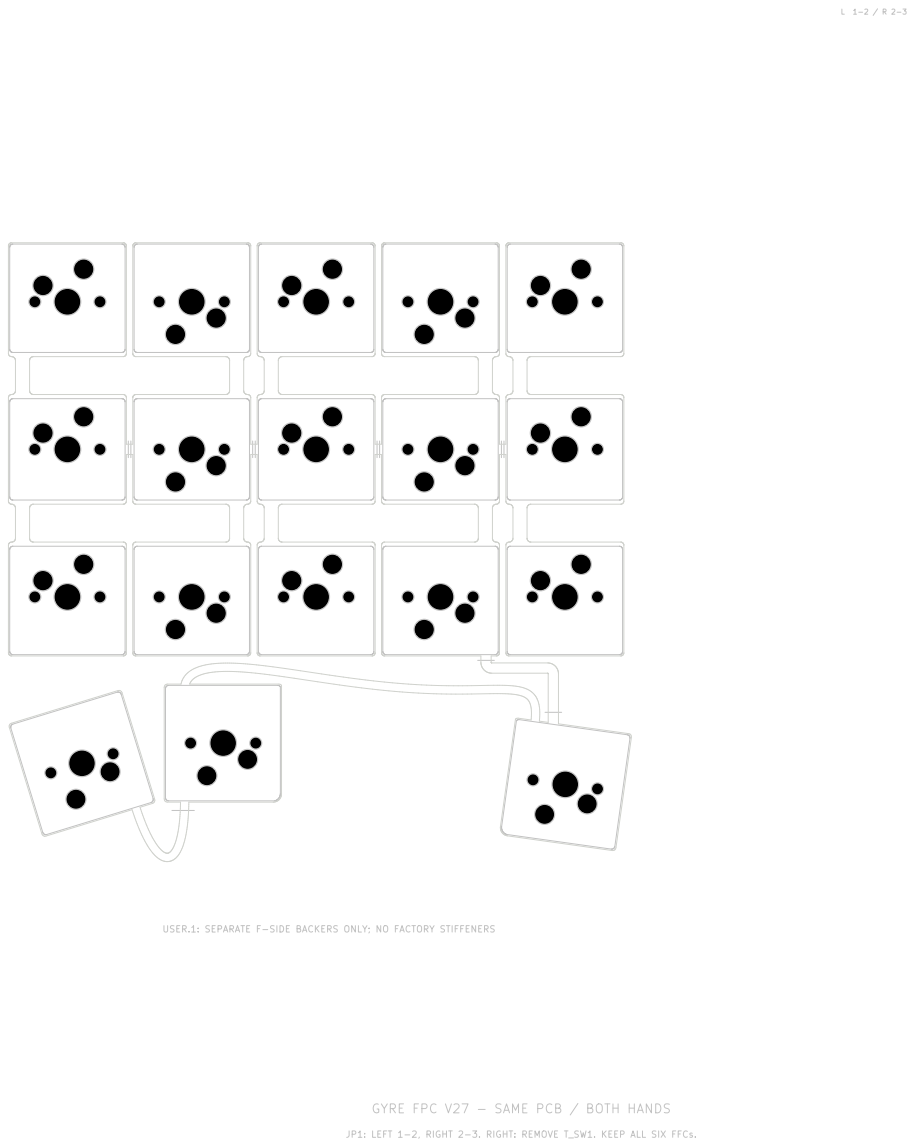
[picture p65: page 1]

USER.1: SEPARATE F-SIDE BACKERS ONLY; NO FACTORY STIFFENERS

JP1: LEFT 1-2, RIGHT 2-3. RIGHT: REMOVE T_SW1. KEEP ALL SIX FFCs. GYRE FPC V27 - SAME PCB / BOTH HANDS
