GavynDracula/GyreNano/pcb/keyfield-fr4/images/assembly-reference.pdf

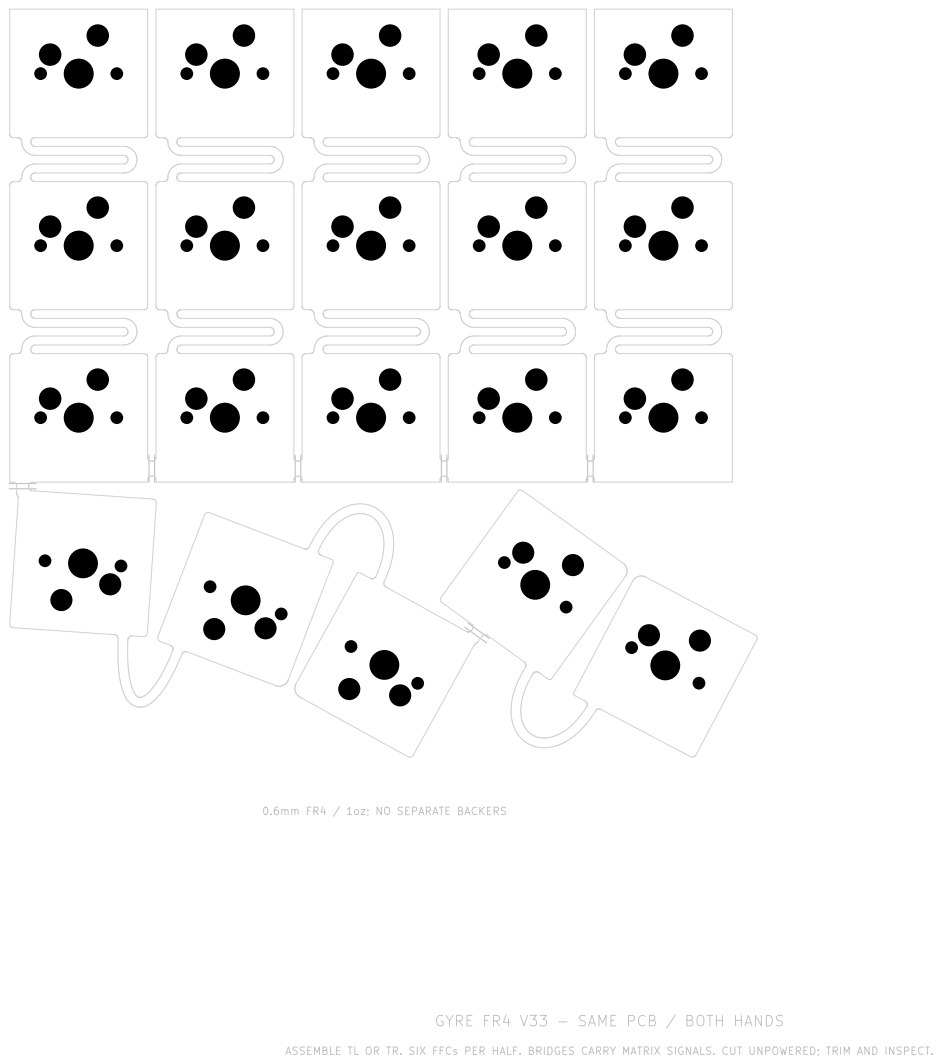
[picture p66: page 1]

ASSEMBLE TL OR TR. SIX FFCs PER HALF. BRIDGES CARRY MATRIX SIGNALS. CUT UNPOWERED; TRIM AND INSPECT. GYRE FR4 V33 - SAME PCB / BOTH HANDS
