GavynDracula/GyreNano/pcb/keyfield-fr4/alternative-isolated/images/assembly-reference.pdf

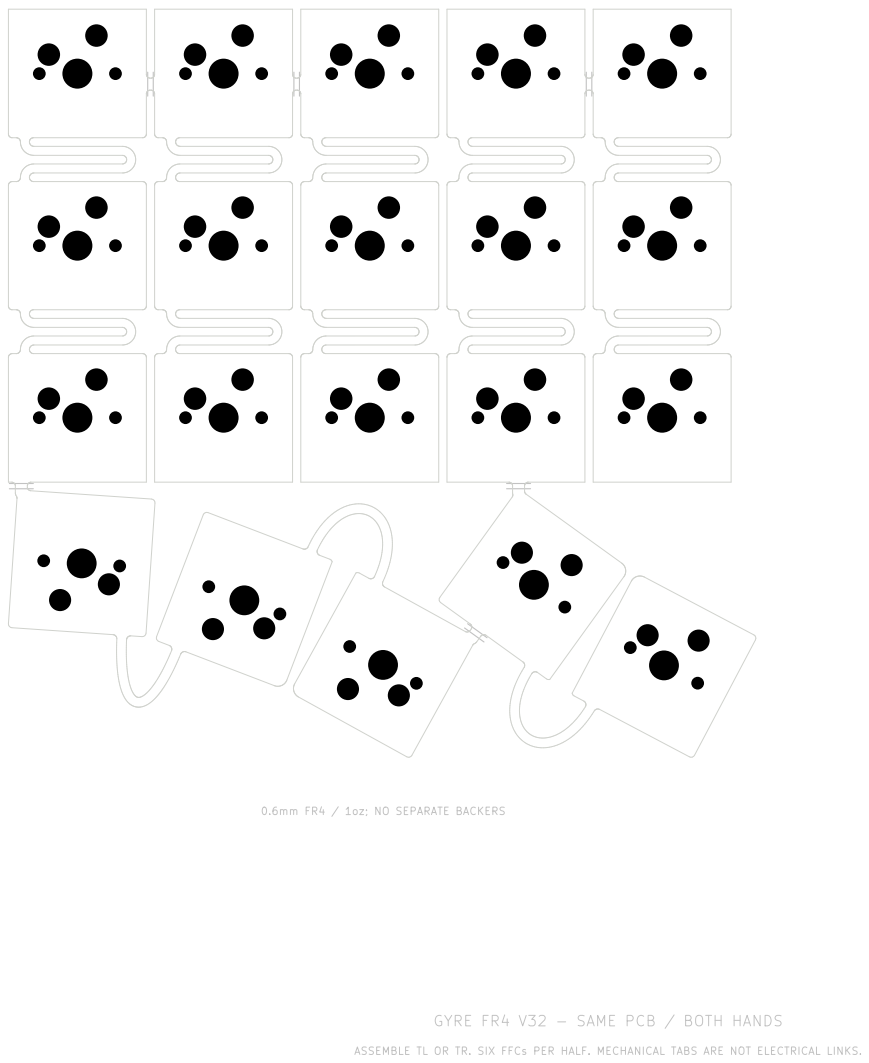
[picture p67: page 1]

ASSEMBLE TL OR TR. SIX FFCs PER HALF. MECHANICAL TABS ARE NOT ELECTRICAL LINKS. GYRE FR4 V32 - SAME PCB / BOTH HANDS
