GavynDracula/GyreNano/pcb/keyfield-fpc/images/GyreNanoKeyfieldFPCV27-layout.pdf

# GyreNano 3x5 | common FPC V27 Five columns + ONE common three-key thumb branch

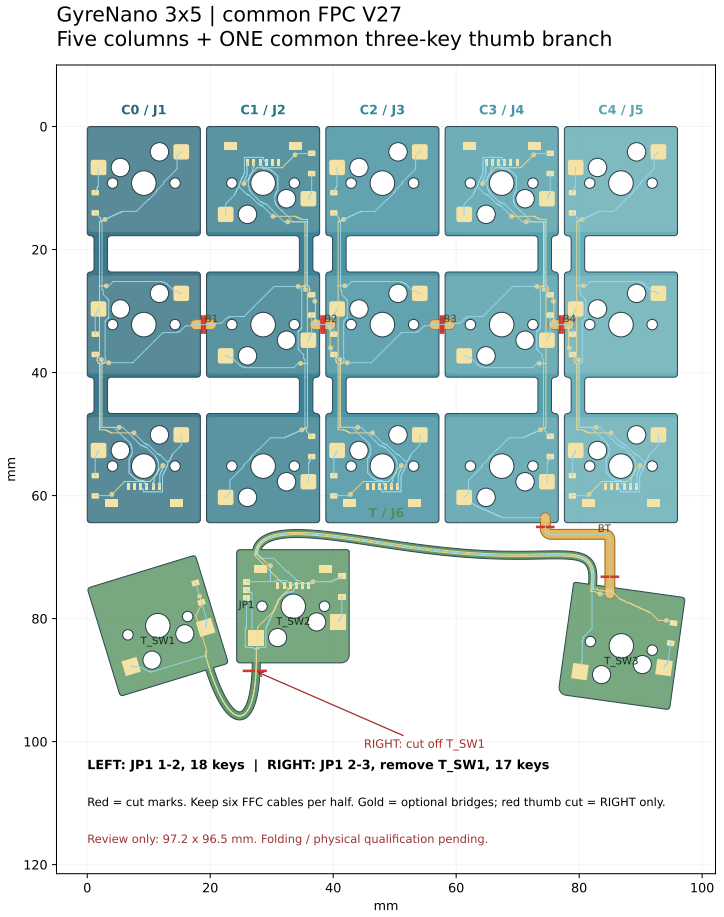
[picture p68: page 1]

T_SW1 | RIGHT: cut off T_SW1

LEFT: JP1 1-2, 18 keys | RIGHT: JP1 2-3, remove T_SW1, 17 keys Red = cut marks. Keep six FFC cables per half. Gold = optional bridges; red thumb cut = RIGHT only. Review only: 97.2 x 96.5 mm. Folding / physical qualification pending.
