GavynDracula/GyreNano/pcb/keyfield-fr4/images/GyreNanoKeyfieldFR4V33-layout.pdf

# GyreNano 3x5 | FR4 V33 - functional interconnect prototype Five columns + left THREE-key / right TWO-key thumb branches; choose one

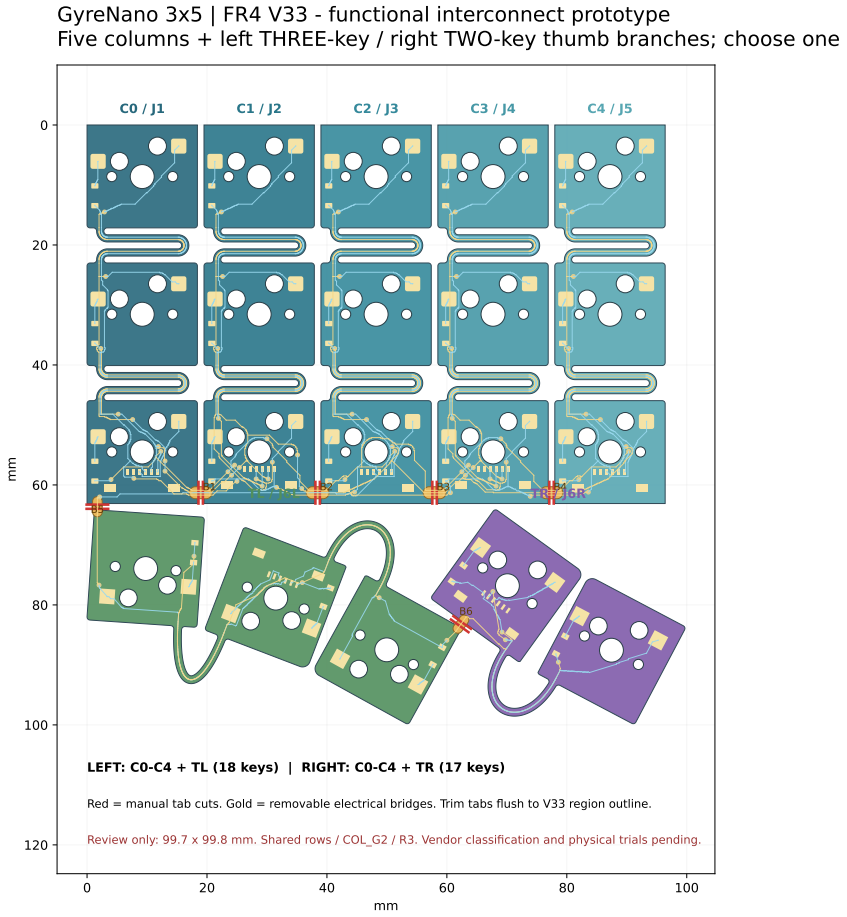
[picture p69: page 1]

LEFT: C0-C4 + TL (18 keys) | RIGHT: C0-C4 + TR (17 keys)

Red = manual tab cuts. Gold = removable electrical bridges. Trim tabs flush to V33 region outline.

Review only: 99.7 x 99.8 mm. Shared rows / COL_G2 / R3. Vendor classification and physical trials pending.
