GavynDracula/GyreNano/pcb/keyfield-fr4/alternative-isolated/images/GyreNanoKeyfieldFR4V32-layout.pdf

# GyreNano 3x5 | FR4 V32 - two original thumb alternatives Five columns + left THREE-key / right TWO-key thumb branches; choose one

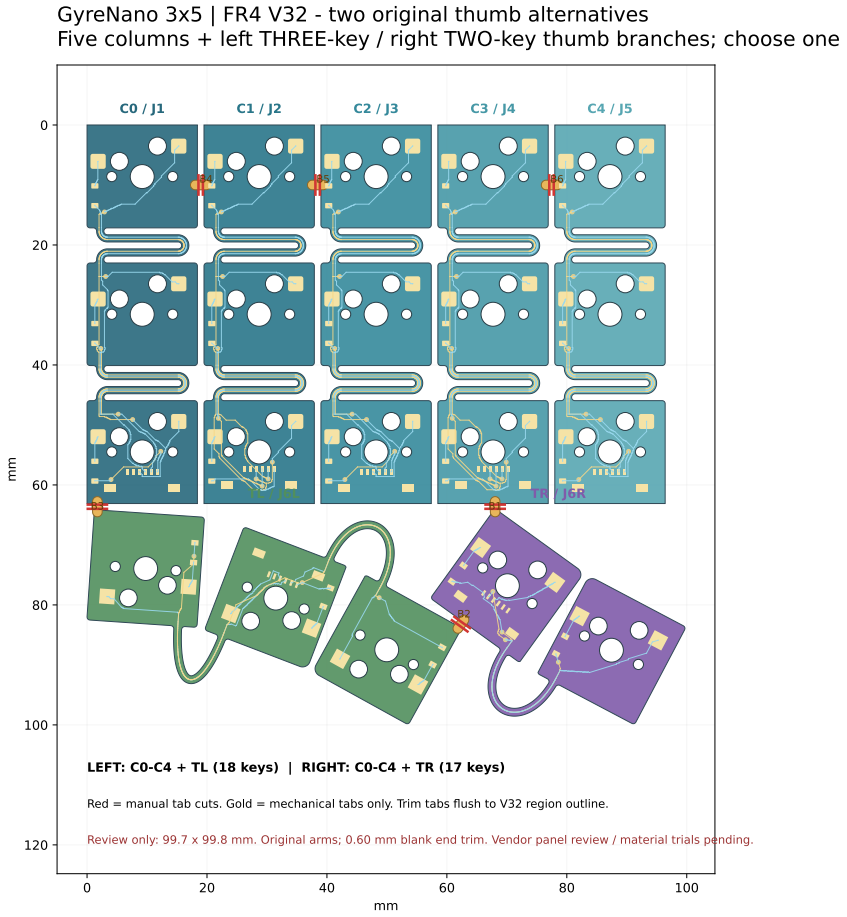
[picture p70: page 1]

LEFT: C0-C4 + TL (18 keys) | RIGHT: C0-C4 + TR (17 keys)

Red = manual tab cuts. Gold = mechanical tabs only. Trim tabs flush to V32 region outline.

Review only: 99.7 x 99.8 mm. Original arms; 0.60 mm blank end trim. Vendor panel review / material trials pending.
