GavynDracula/GyreNano/pcb/keyfield-fpc/images/copper.pdf

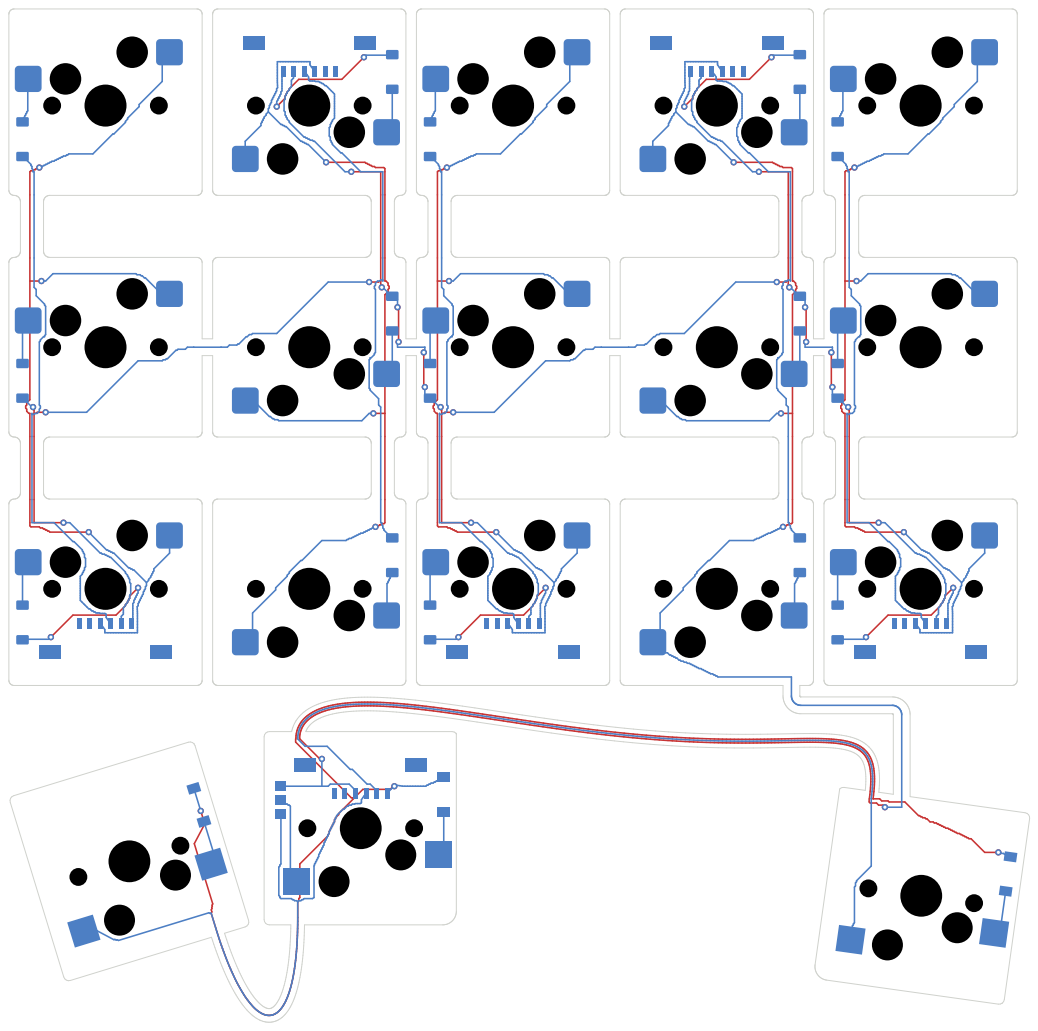
[picture p71: page 1]
