GavynDracula/GyreNano/pcb/keyfield-fr4/images/copper.pdf

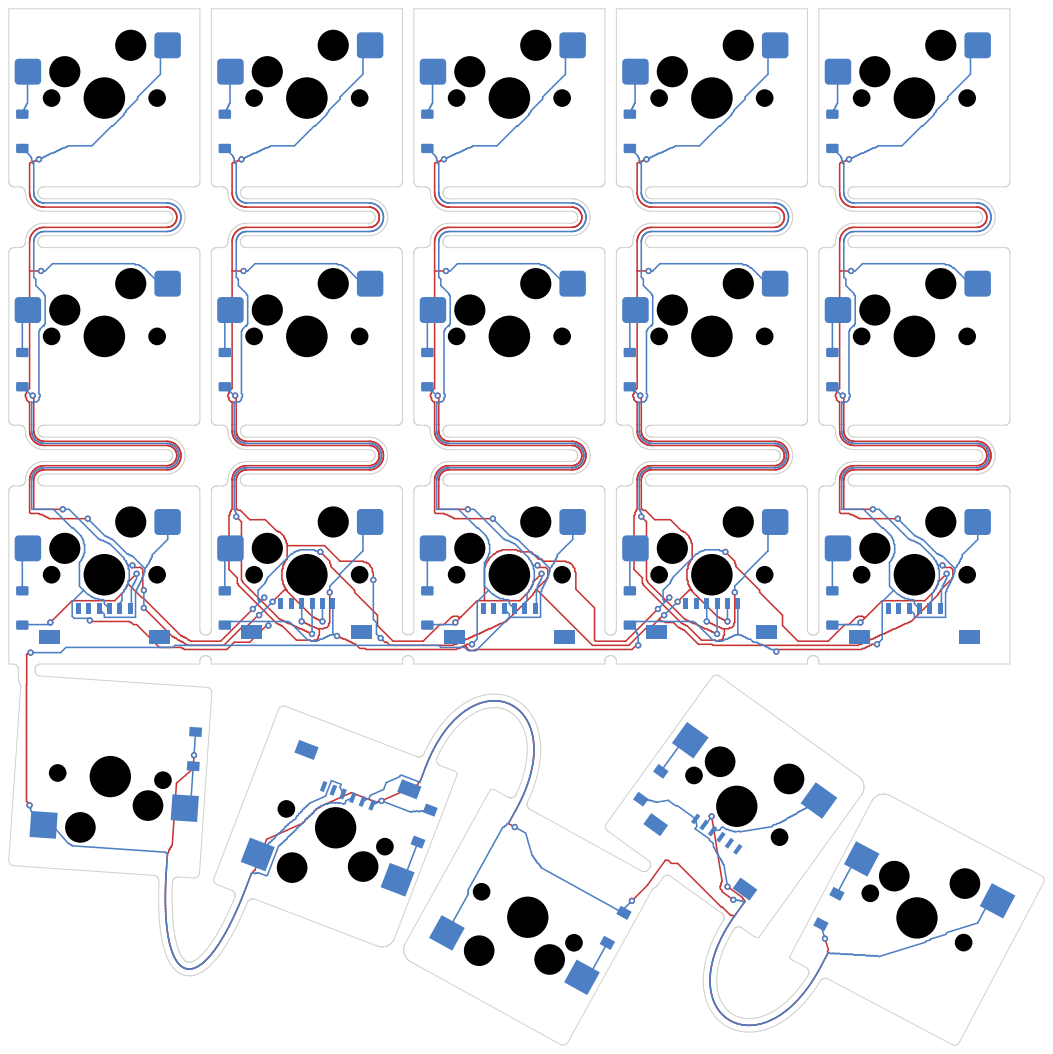
[picture p72: page 1]
