GavynDracula/GyreNano/pcb/keyfield-fr4/alternative-isolated/images/copper.pdf

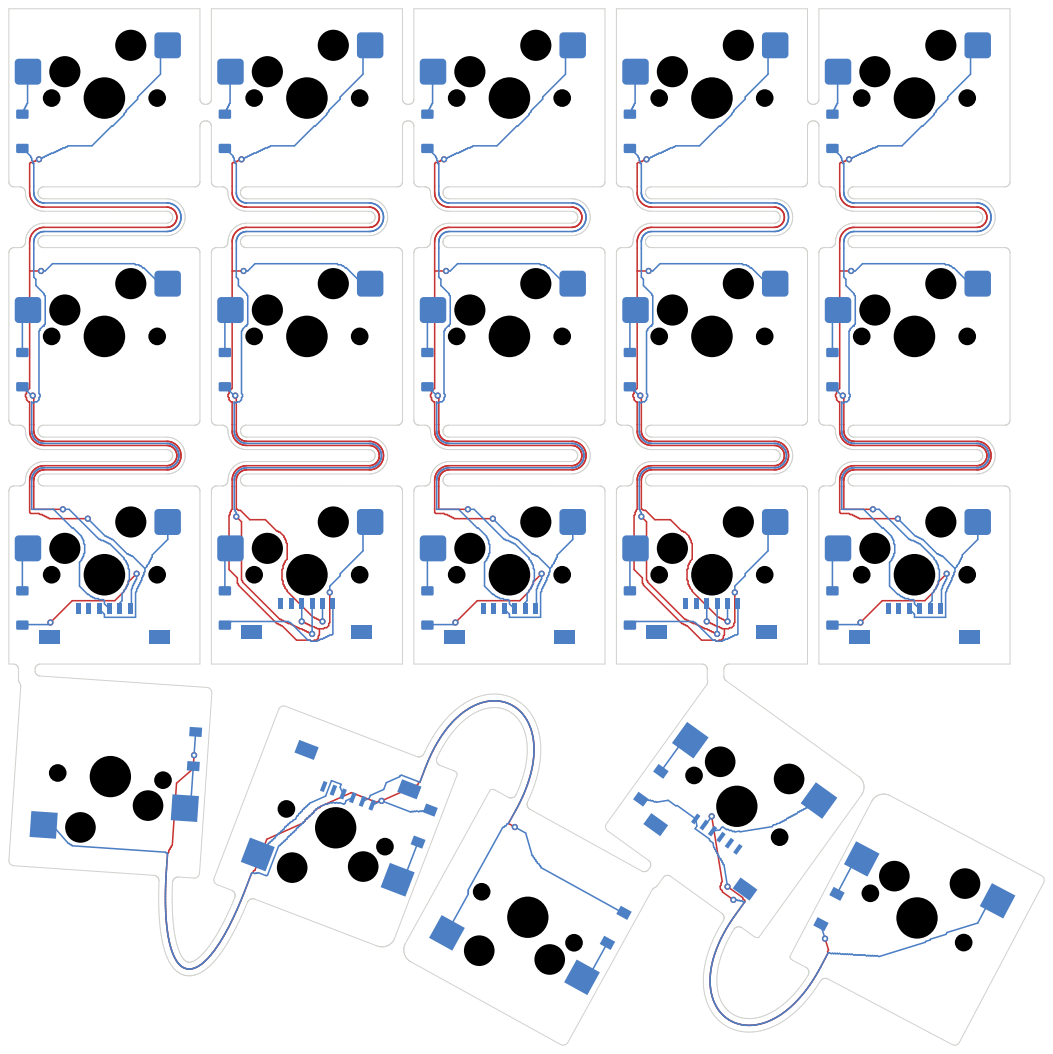
[picture p73: page 1]
