GavynDracula/GyreNano/pcb/holders/reference-kicad/GyreNanoHolderRightV12.kicad_pcb

## KiCad design pcb/holders/reference-kicad/GyreNanoHolderRightV12.kicad_pcb (2026-11-13)

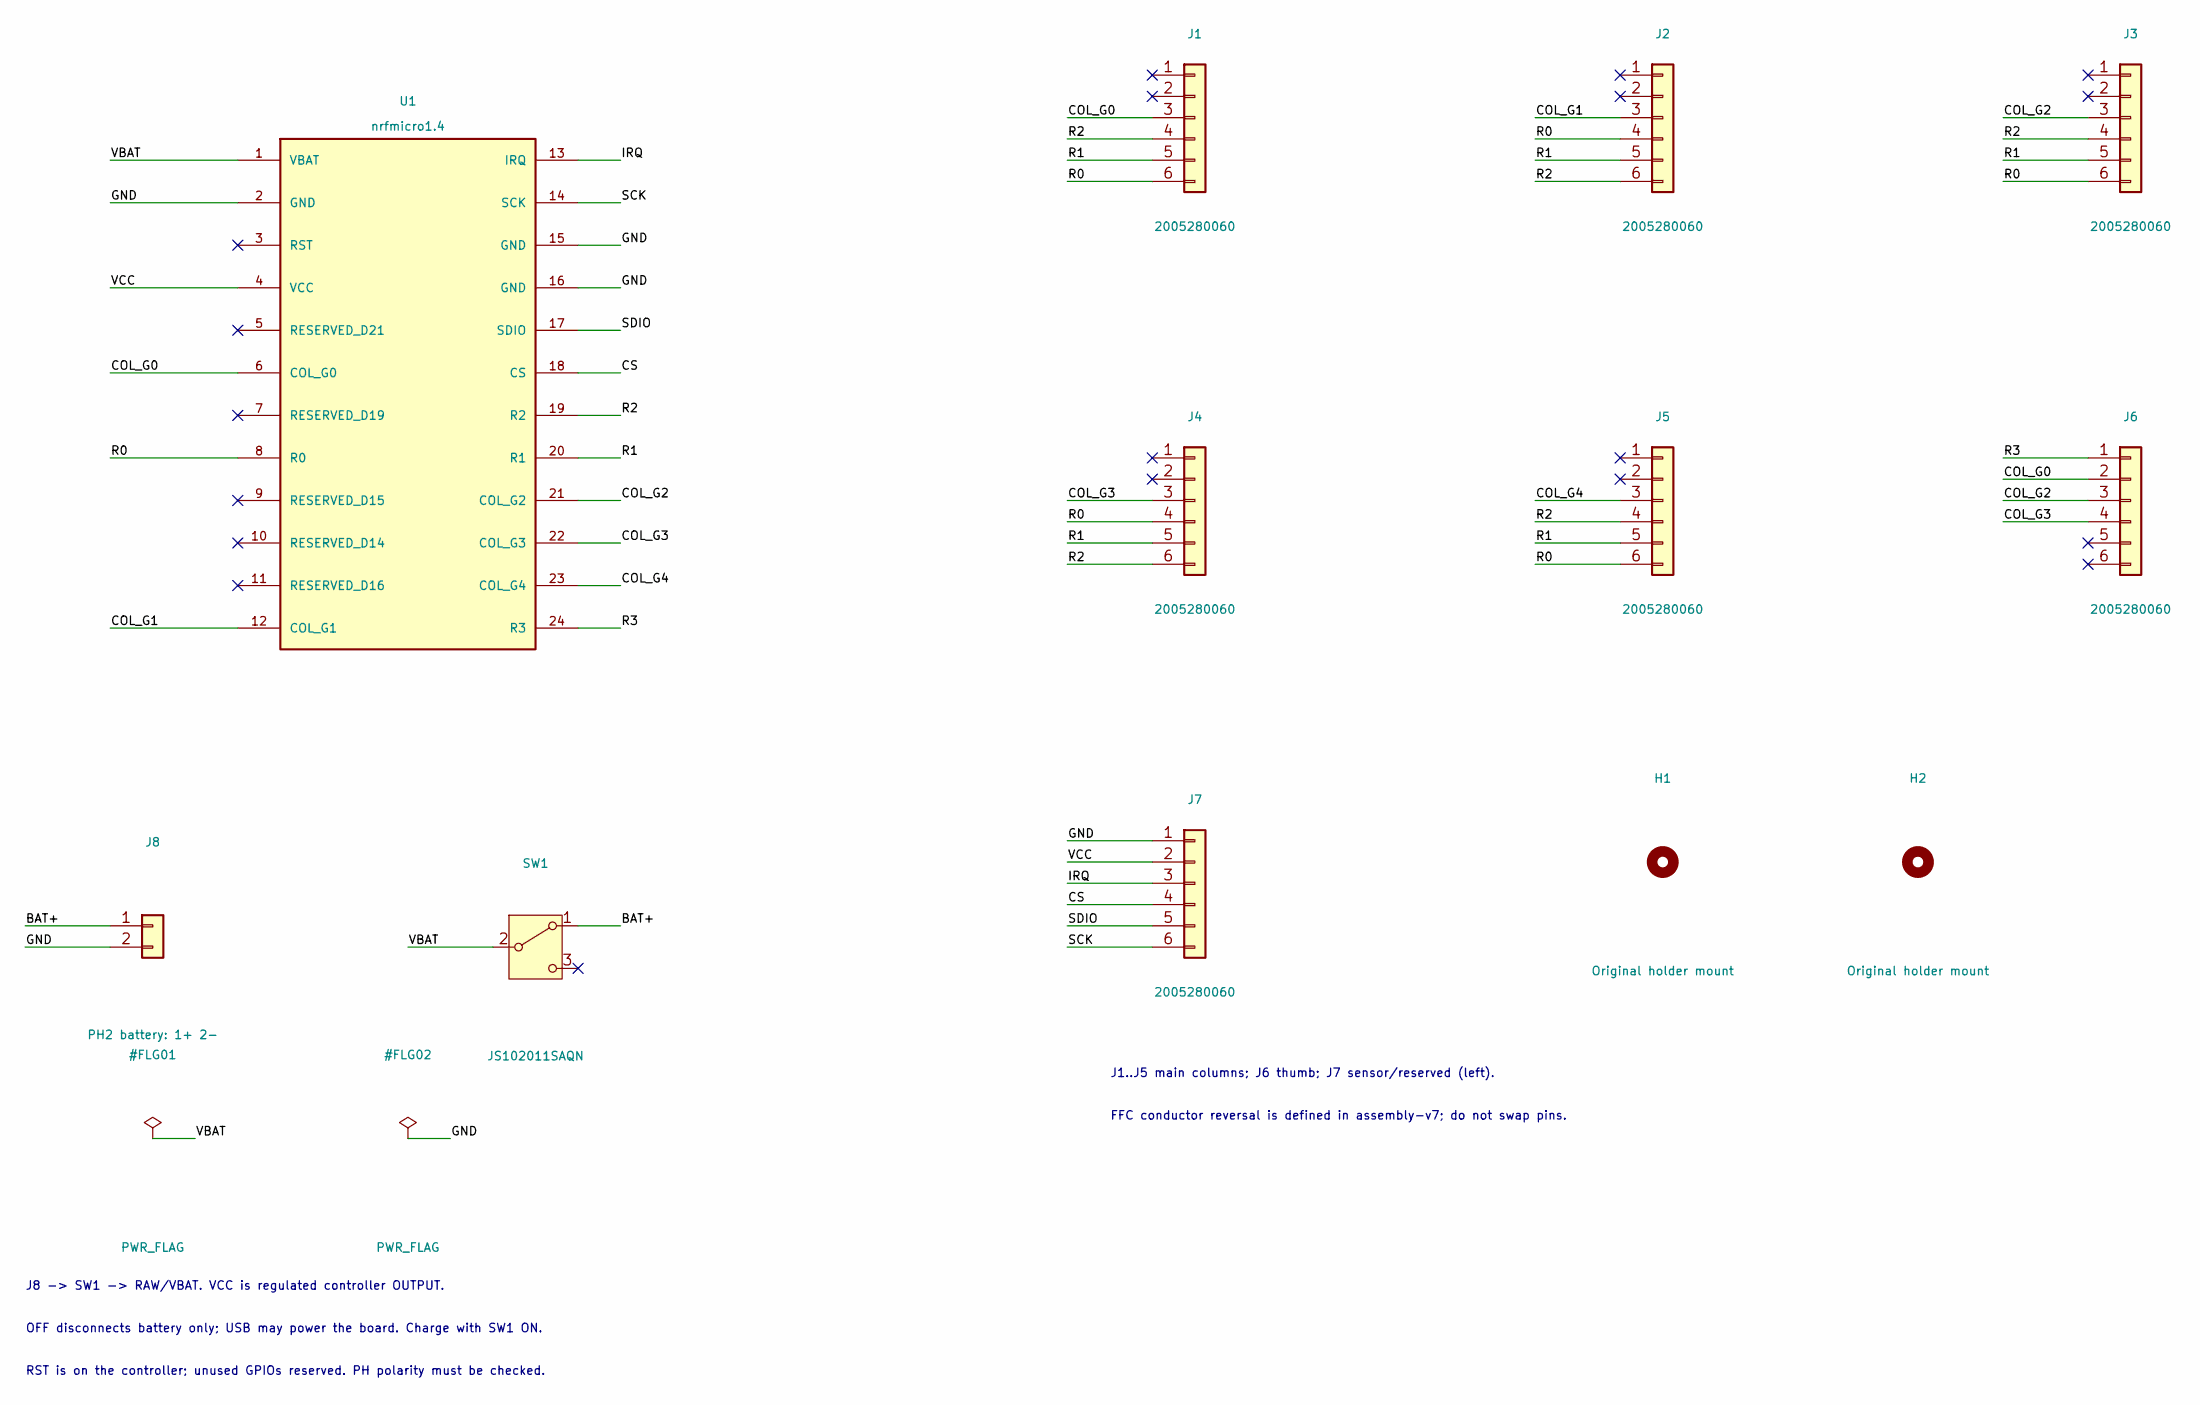
[picture p74: schematic GyreNanoHolderRightV12.kicad_sch, GyreNano right holder]

Parts:
H1, H2: Original holder mount; Mount4
J1: 2005280060; FFC6_right_J1
J2: 2005280060; FFC6_right_J2
J3: 2005280060; FFC6_right_J3
J4: 2005280060; FFC6_right_J4
J5: 2005280060; FFC6_right_J5
J6: 2005280060; Molex_200528-0060_1x06-1MP_P1.00mm_Horizontal
J7: 2005280060; FFC6_right_J7
J8: PH2 battery: 1+ 2-; JST_PH_B2B-PH-SM4-TB_1x02-1MP_P2.00mm_Vertical
SW1: JS102011SAQN; SW_SPDT_CK_JS102011SAQN
U1: nrfmicro1.4; Controller24_right

Connections:
/BAT+: J8.1, SW1.1 (A)
/COL_G0: J1.3, J6.2, U1.6 (COL_G0)
/COL_G1: J2.3, U1.12 (COL_G1)
/COL_G2: J3.3, J6.3, U1.21 (COL_G2)
/COL_G3: J4.3, J6.4, U1.22 (COL_G3)
/COL_G4: J5.3, U1.23 (COL_G4)
/CS: J7.4, U1.18 (CS)
/GND: J7.1, J8.2, U1.2 (GND), U1.15 (GND), U1.16 (GND)
/IRQ: J7.3, U1.13 (IRQ)
/R0: J1.6, J2.4, J3.6, J4.4, J5.6, U1.8 (R0)
/R1: J1.5, J2.5, J3.5, J4.5, J5.5, U1.20 (R1)
/R2: J1.4, J2.6, J3.4, J4.6, J5.4, U1.19 (R2)
/R3: J6.1, U1.24 (R3)
/SCK: J7.6, U1.14 (SCK)
/SDIO: J7.5, U1.17 (SDIO)
/VBAT: SW1.2 (B), U1.1 (VBAT)
/VCC: J7.2, U1.4 (VCC)

Notes on the sheet:
J1..J5 main columns; J6 thumb; J7 sensor/reserved (left).
FFC conductor reversal is defined in assembly-v7; do not swap pins.
J8 -> SW1 -> RAW/VBAT. VCC is regulated controller OUTPUT.
OFF disconnects battery only; USB may power the board. Charge with SW1 ON.
RST is on the controller; unused GPIOs reserved. PH polarity must be checked.

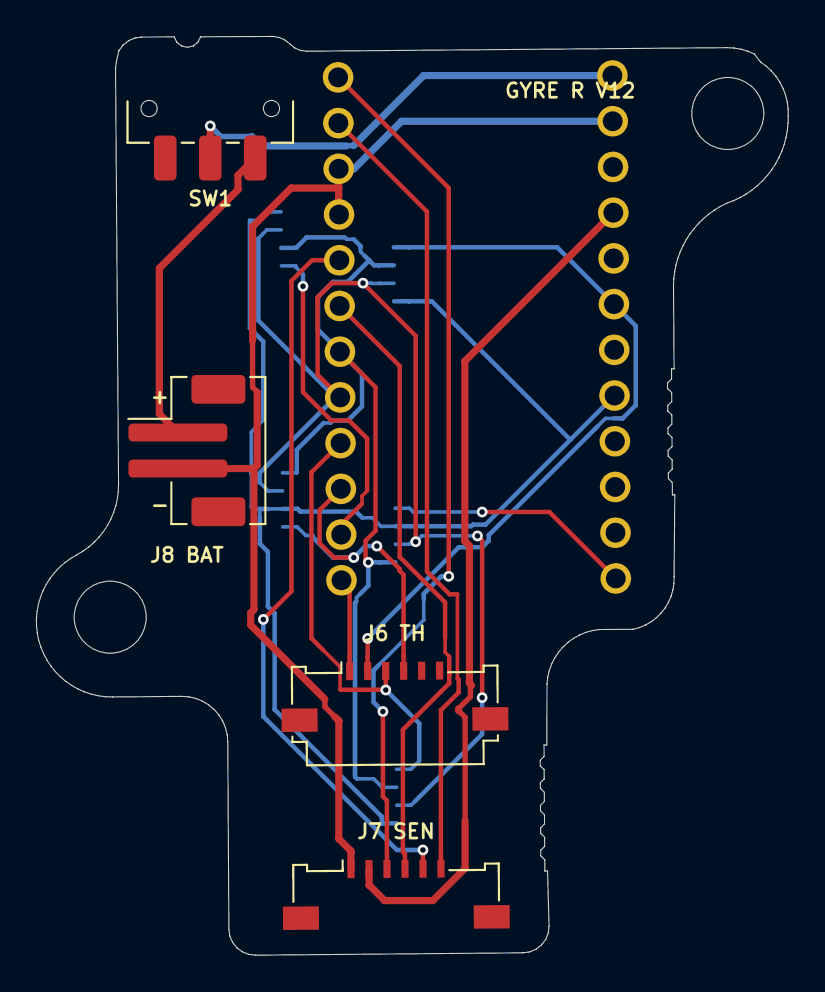
[picture p75: board GyreNanoHolderRightV12.kicad_pcb from above]

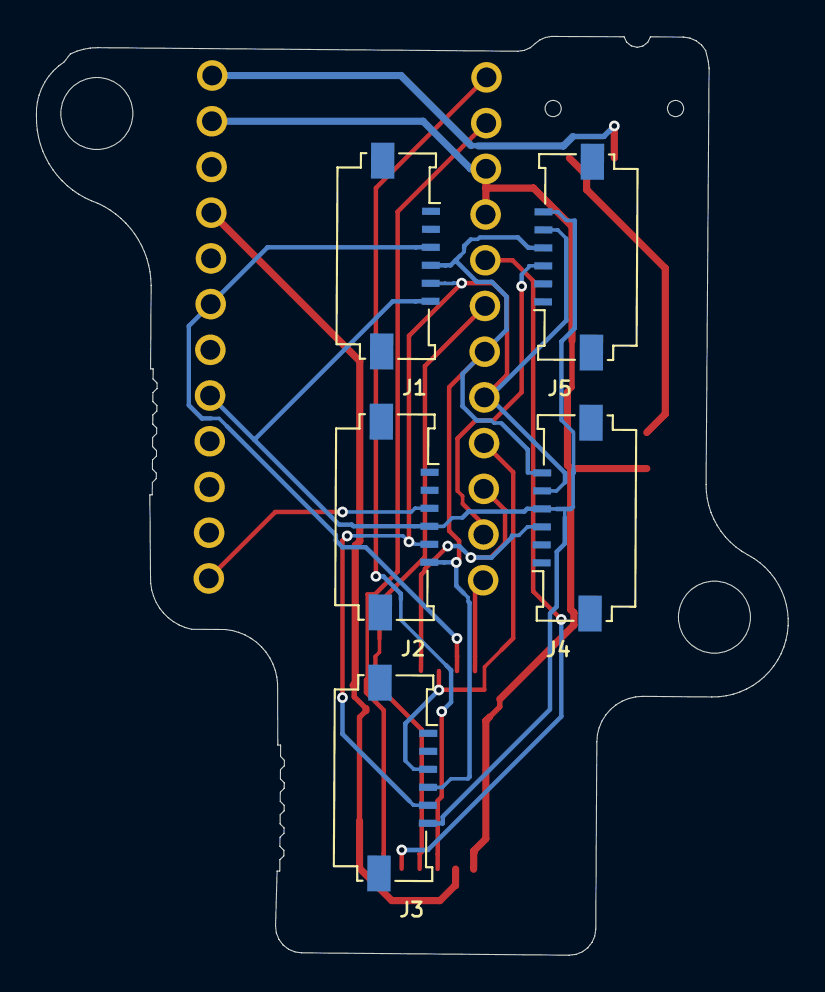
[picture p76: board GyreNanoHolderRightV12.kicad_pcb from below]

Board: 2 copper layers, 41.8 x 51.0 mm, 12 parts (5 on the bottom side), 17 nets.
