GavynDracula/GyreNano/pcb/keyfield-fpc/kicad/GyreNanoKeyfieldFPCV27.kicad_pcb

## KiCad design pcb/keyfield-fpc/kicad/GyreNanoKeyfieldFPCV27.kicad_pcb (2026-11-13)

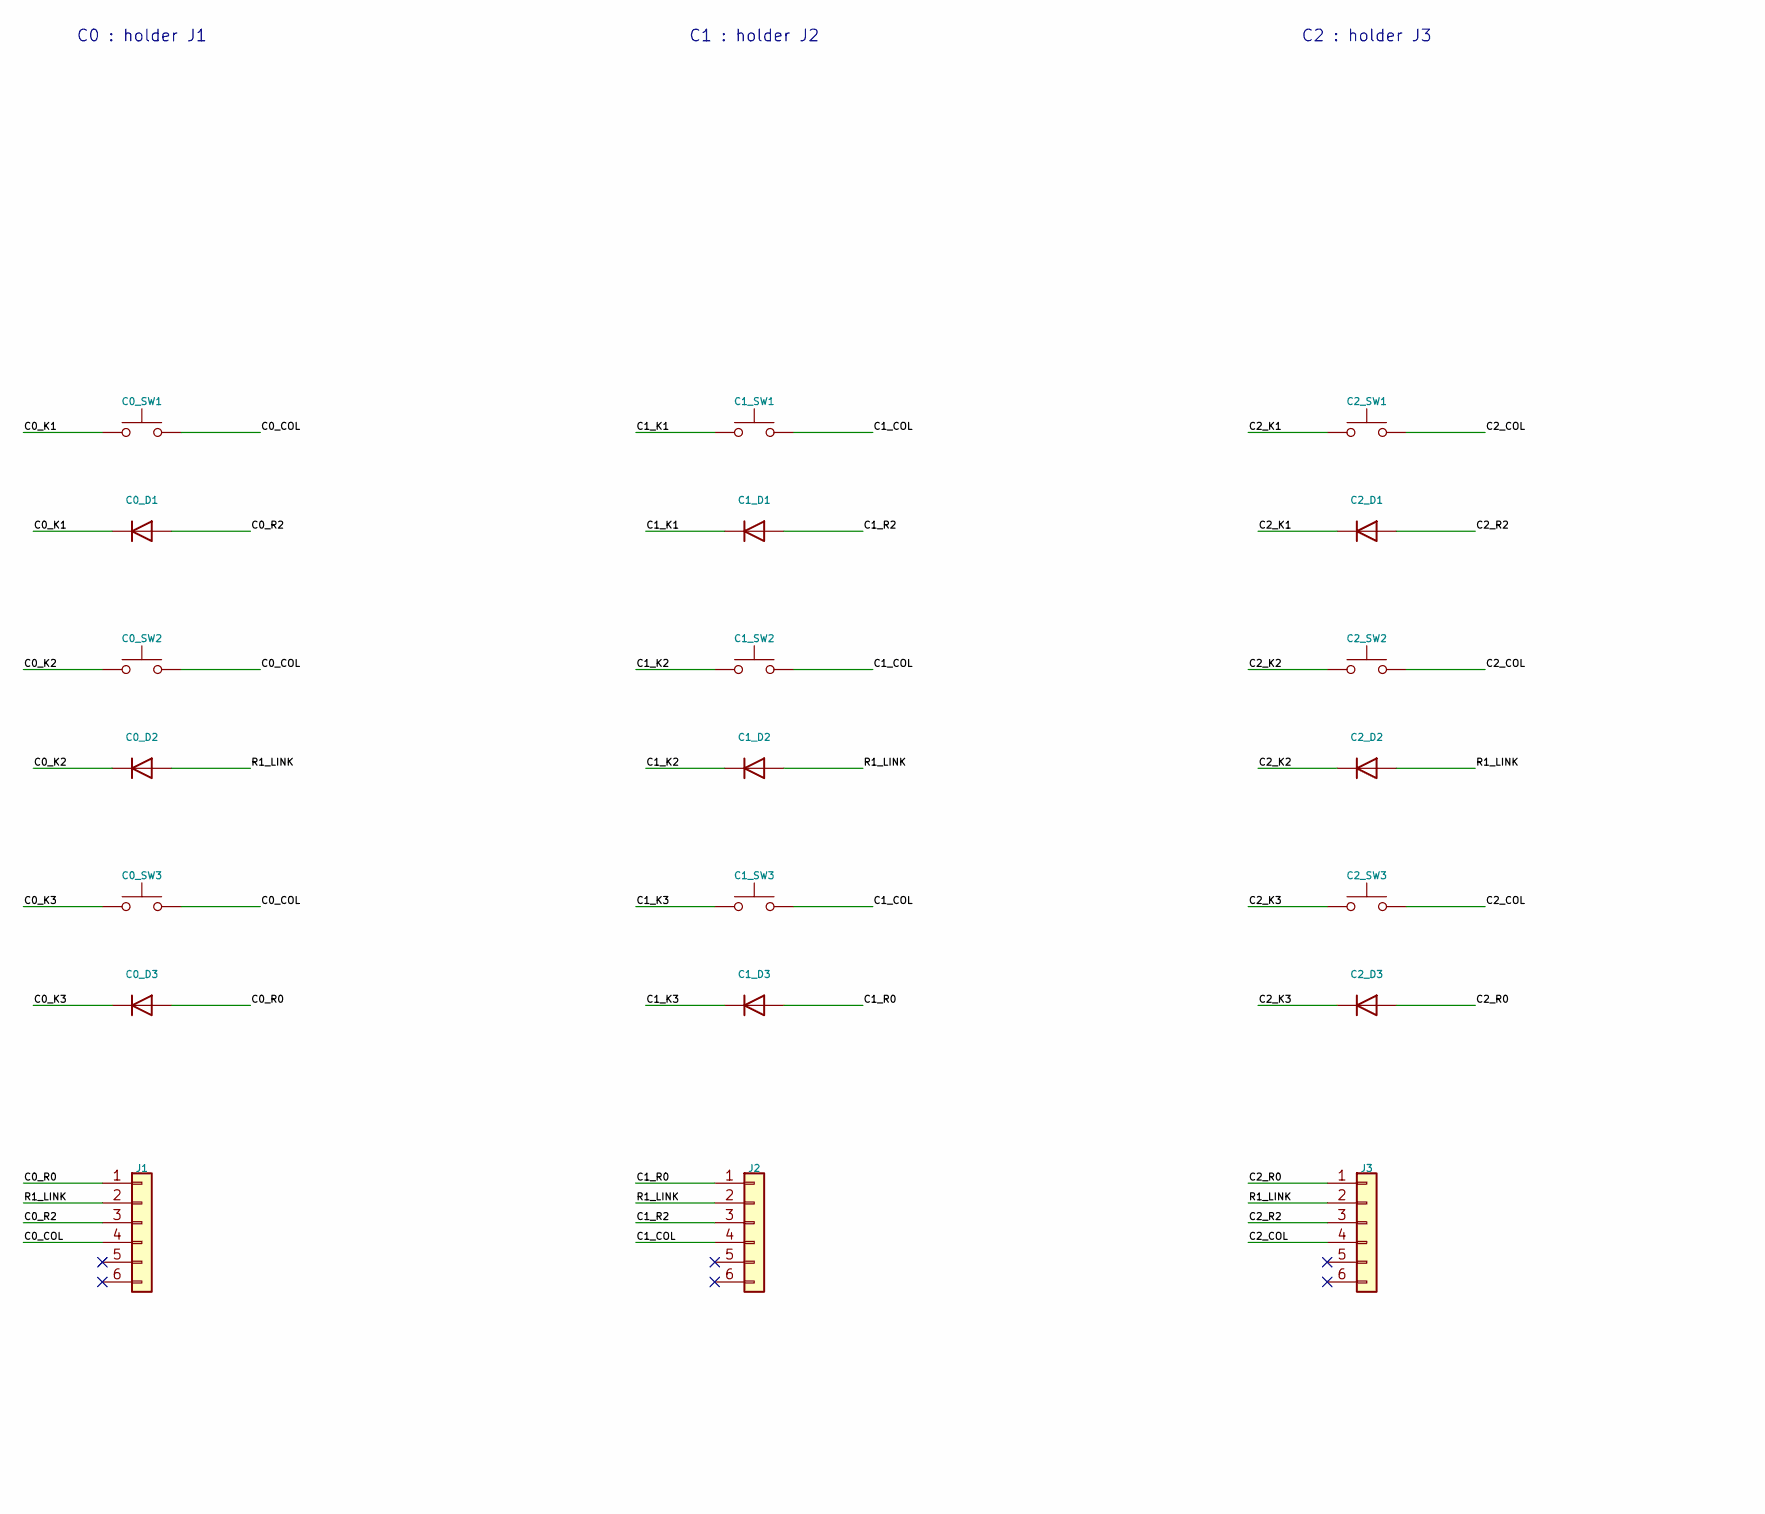
[picture p77: schematic GyreNanoKeyfieldFPCV27.kicad_sch, GyreNano 3x5 selectable keyfield FPC, part in row 1, column 1]

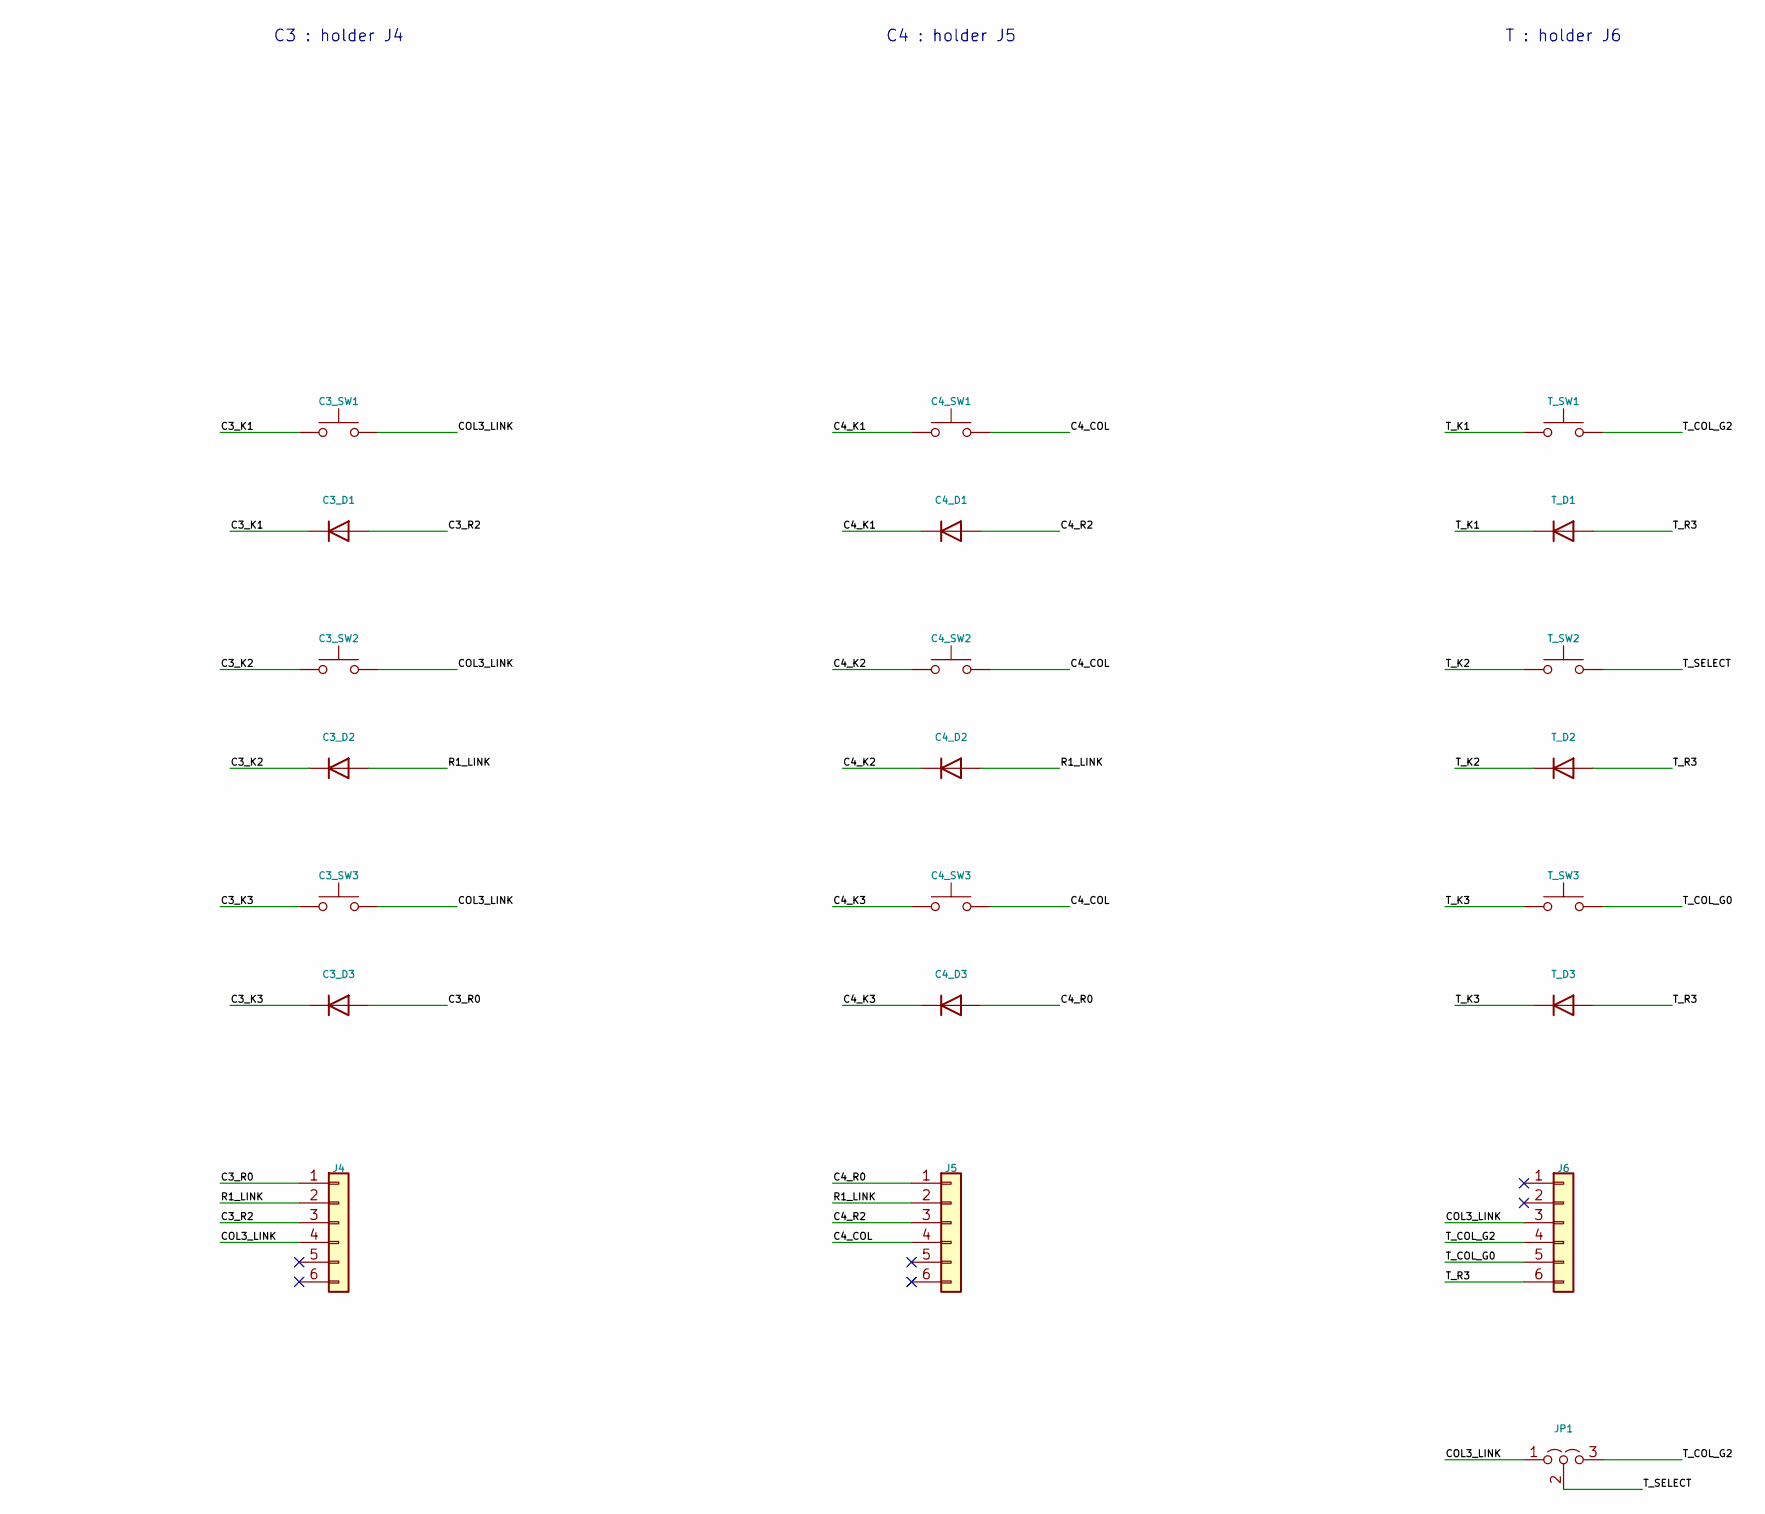
[picture p78: schematic GyreNanoKeyfieldFPCV27.kicad_sch, GyreNano 3x5 selectable keyfield FPC, part in row 1, column 2]

Parts:
C0_D1: 1N4148W-7-F; D_C0_D1
C0_D2: 1N4148W-7-F; D_C0_D2
C0_D3: 1N4148W-7-F; D_C0_D3
C0_SW1: CPG151101S11-16; SW_C0_SW1
C0_SW2: CPG151101S11-16; SW_C0_SW2
C0_SW3: CPG151101S11-16; SW_C0_SW3
C1_D1: 1N4148W-7-F; D_C1_D1
C1_D2: 1N4148W-7-F; D_C1_D2
C1_D3: 1N4148W-7-F; D_C1_D3
C1_SW1: CPG151101S11-16; SW_C1_SW1
C1_SW2: CPG151101S11-16; SW_C1_SW2
C1_SW3: CPG151101S11-16; SW_C1_SW3
C2_D1: 1N4148W-7-F; D_C2_D1
C2_D2: 1N4148W-7-F; D_C2_D2
C2_D3: 1N4148W-7-F; D_C2_D3
C2_SW1: CPG151101S11-16; SW_C2_SW1
C2_SW2: CPG151101S11-16; SW_C2_SW2
C2_SW3: CPG151101S11-16; SW_C2_SW3
C3_D1: 1N4148W-7-F; D_C3_D1
C3_D2: 1N4148W-7-F; D_C3_D2
C3_D3: 1N4148W-7-F; D_C3_D3
C3_SW1: CPG151101S11-16; SW_C3_SW1
C3_SW2: CPG151101S11-16; SW_C3_SW2
C3_SW3: CPG151101S11-16; SW_C3_SW3
C4_D1: 1N4148W-7-F; D_C4_D1
C4_D2: 1N4148W-7-F; D_C4_D2
C4_D3: 1N4148W-7-F; D_C4_D3
C4_SW1: CPG151101S11-16; SW_C4_SW1
C4_SW2: CPG151101S11-16; SW_C4_SW2
C4_SW3: CPG151101S11-16; SW_C4_SW3
J1: 2005280060; Molex_1x06_J1
J2: 2005280060; Molex_1x06_J2
J3: 2005280060; Molex_1x06_J3
J4: 2005280060; Molex_1x06_J4
J5: 2005280060; Molex_1x06_J5
J6: 2005280060; Molex_1x06_J6
JP1: L:1-2 / R:2-3; Jumper_3_Open_JP1
T_D1: 1N4148W-7-F; D_T_D1
T_D2: 1N4148W-7-F; D_T_D2
T_D3: 1N4148W-7-F; D_T_D3
T_SW1: MX hot-swap; SW_T_SW1
T_SW2: MX hot-swap; SW_T_SW2
T_SW3: MX hot-swap; SW_T_SW3

Connections:
/C0_COL: C0_SW1.2, C0_SW2.2, C0_SW3.2, J1.4
/C0_K1: C0_D1.1 (K), C0_SW1.1
/C0_K2: C0_D2.1 (K), C0_SW2.1
/C0_K3: C0_D3.1 (K), C0_SW3.1
/C0_R0: C0_D3.2 (A), J1.1
/C0_R2: C0_D1.2 (A), J1.3
/C1_COL: C1_SW1.2, C1_SW2.2, C1_SW3.2, J2.4
/C1_K1: C1_D1.1 (K), C1_SW1.1
/C1_K2: C1_D2.1 (K), C1_SW2.1
/C1_K3: C1_D3.1 (K), C1_SW3.1
/C1_R0: C1_D3.2 (A), J2.1
/C1_R2: C1_D1.2 (A), J2.3
/C2_COL: C2_SW1.2, C2_SW2.2, C2_SW3.2, J3.4
/C2_K1: C2_D1.1 (K), C2_SW1.1
/C2_K2: C2_D2.1 (K), C2_SW2.1
/C2_K3: C2_D3.1 (K), C2_SW3.1
/C2_R0: C2_D3.2 (A), J3.1
/C2_R2: C2_D1.2 (A), J3.3
/C3_K1: C3_D1.1 (K), C3_SW1.1
/C3_K2: C3_D2.1 (K), C3_SW2.1
/C3_K3: C3_D3.1 (K), C3_SW3.1
/C3_R0: C3_D3.2 (A), J4.1
/C3_R2: C3_D1.2 (A), J4.3
/C4_COL: C4_SW1.2, C4_SW2.2, C4_SW3.2, J5.4
/C4_K1: C4_D1.1 (K), C4_SW1.1
/C4_K2: C4_D2.1 (K), C4_SW2.1
/C4_K3: C4_D3.1 (K), C4_SW3.1
/C4_R0: C4_D3.2 (A), J5.1
/C4_R2: C4_D1.2 (A), J5.3
/COL3_LINK: C3_SW1.2, C3_SW2.2, C3_SW3.2, J4.4, J6.3, JP1.1 (A)
/R1_LINK: C0_D2.2 (A), C1_D2.2 (A), C2_D2.2 (A), C3_D2.2 (A), C4_D2.2 (A), J1.2, J2.2, J3.2, J4.2, J5.2
/T_COL_G0: J6.5, T_SW3.2
/T_COL_G2: J6.4, JP1.3 (B), T_SW1.2
/T_K1: T_D1.1 (K), T_SW1.1
/T_K2: T_D2.1 (K), T_SW2.1
/T_K3: T_D3.1 (K), T_SW3.1
/T_R3: J6.6, T_D1.2 (A), T_D2.2 (A), T_D3.2 (A)
/T_SELECT: JP1.2 (C), T_SW2.2

Notes on the sheet:
C0 : holder J1
C1 : holder J2
C2 : holder J3
C3 : holder J4
C4 : holder J5
T : holder J6

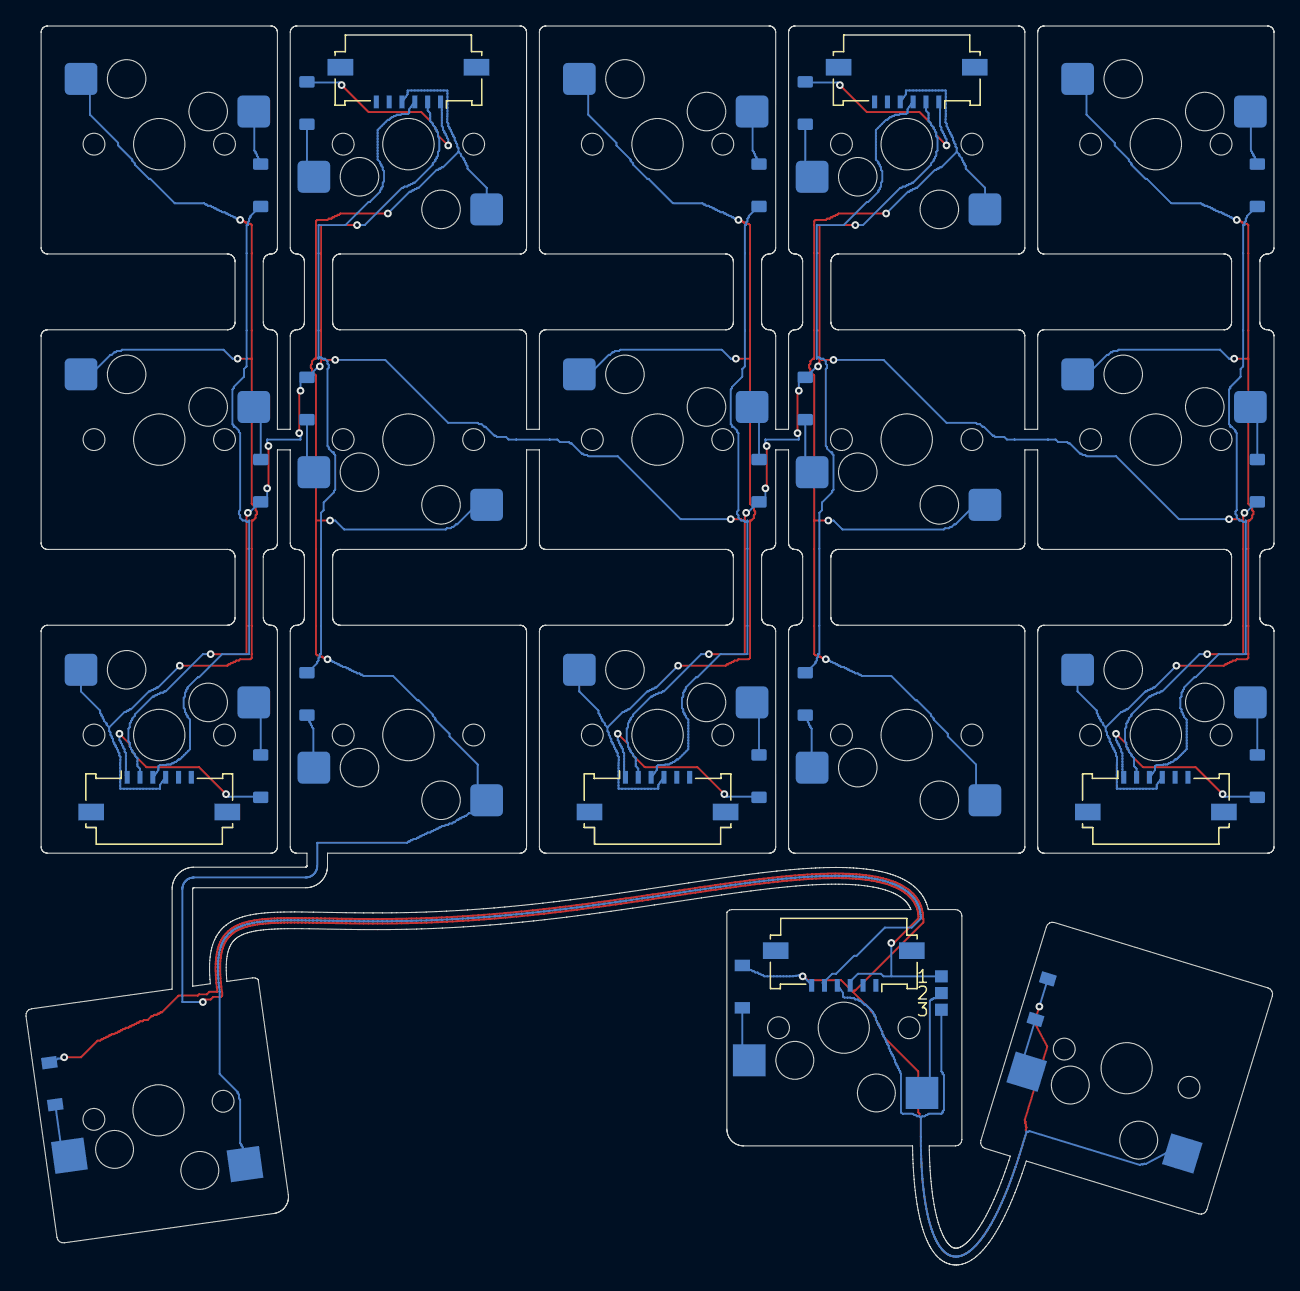
[picture p79: board GyreNanoKeyfieldFPCV27.kicad_pcb from below]

Board: 2 copper layers, 97.2 x 96.5 mm, 43 parts (43 on the bottom side), 38 nets.
