GavynDracula/GyreNano/pcb/sensor/reference-kicad/GyreNanoSensor.kicad_pcb

## KiCad design pcb/sensor/reference-kicad/GyreNanoSensor.kicad_pcb (2026-11-13)

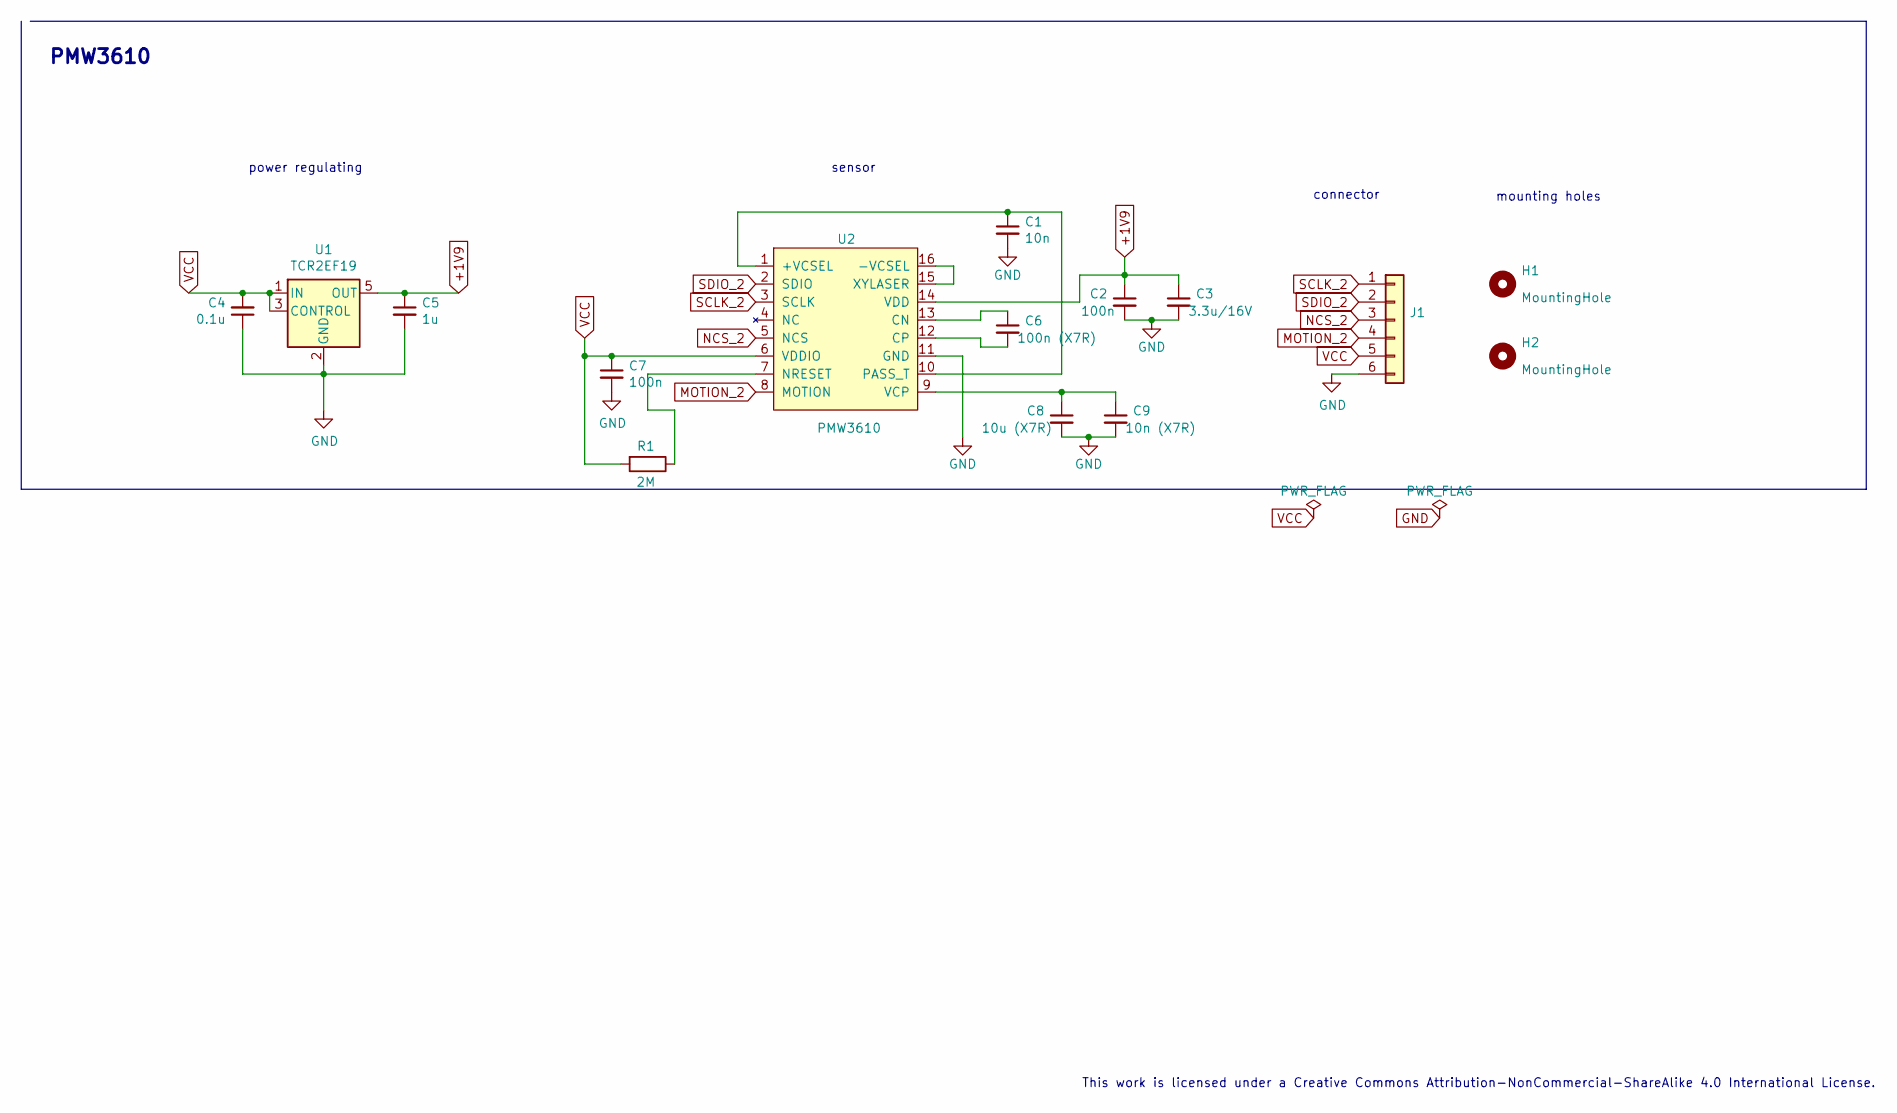
[picture p80: schematic GyreNanoSensor.kicad_sch]

Parts:
C1: 10n; C1_C_0603_1608Metric; LCSC C19666
C2: 100n; C2_C_0603_1608Metric; LCSC C19666
C3: 3.3u/16V; C3_C_0603_1608Metric; LCSC C19666
C4: 0.1u; C4_C_0603_1608Metric; LCSC C14663
C5: 1u; C5_C_0603_1608Metric; LCSC C15849
C6: 100n (X7R); C6_C_0603_1608Metric; LCSC C19666
C7: 100n; C7_C_0603_1608Metric; LCSC C19666
C8: 10u (X7R); C8_C_0603_1608Metric; LCSC C19666
C9: 10n (X7R); C9_C_0603_1608Metric; LCSC C19666
H1: MountingHole; H1_MountingHole_3.2mm_M3_ISO7380_Pad
H2: MountingHole; H2_
J1: 2005280060; Molex_200528-0060_1x06-1MP_P1.00mm_Horizontal
R1: 2M; R1_R_0603_1608Metric
U1: TCR2EF19; U1_SOT-23-5; LCSC C146366
U2: PMW3610; U2_PMW3610

Connections:
+1V9: C2.1, C3.1, C5.1, U1.5 (OUT), U2.14 (VDD)
GND: C1.2, C2.2, C3.2, C4.1, C5.2, C7.2, C8.2, C9.2, J1.6, U1.2 (GND), U2.11 (GND)
MOTION_2: J1.4, U2.8 (MOTION)
NCS_2: J1.3, U2.5 (NCS)
unnamed: C1.1, U2.1 (+VCSEL), U2.10 (PASS_T)
unnamed: U2.15 (XYLASER), U2.16 (-VCSEL)
unnamed: C6.1, U2.13 (CN)
unnamed: C6.2, U2.12 (CP)
unnamed: R1.1, U2.7 (NRESET)
unnamed: C8.1, C9.1, U2.9 (VCP)
SCLK_2: J1.1, U2.3 (SCLK)
SDIO_2: J1.2, U2.2 (SDIO)
VCC: C4.2, C7.1, J1.5, R1.2, U1.1 (IN), U1.3 (EN), U2.6 (VDDIO)

Notes on the sheet:
This work is licensed under a Creative Commons Attribution-NonCommercial-ShareAlike 4.0 International License.
sensor
PMW3610
power regulating
mounting holes
connector

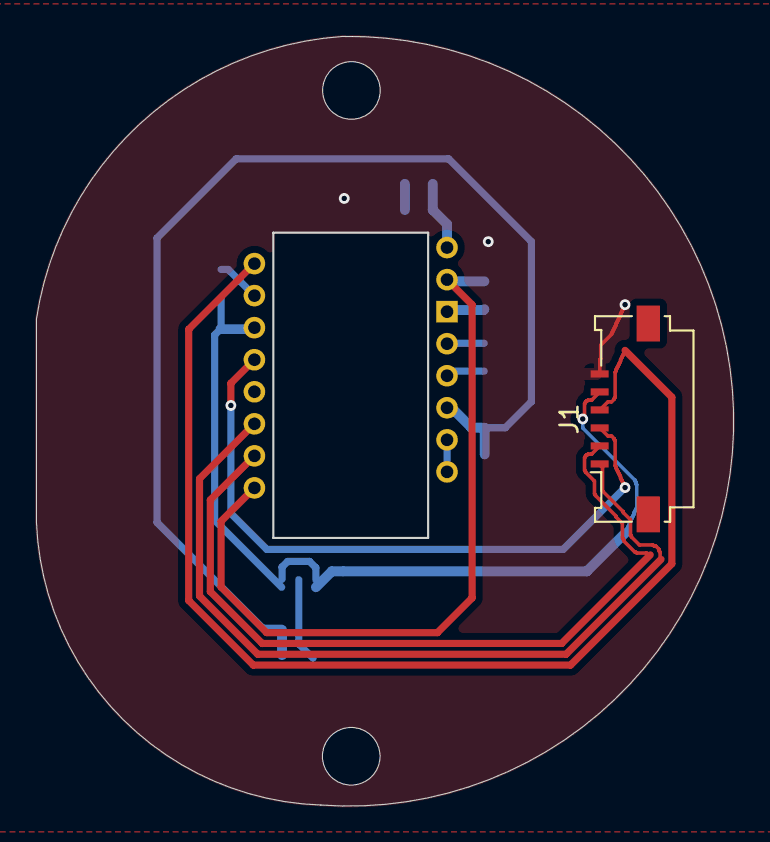
[picture p81: board GyreNanoSensor.kicad_pcb from above]

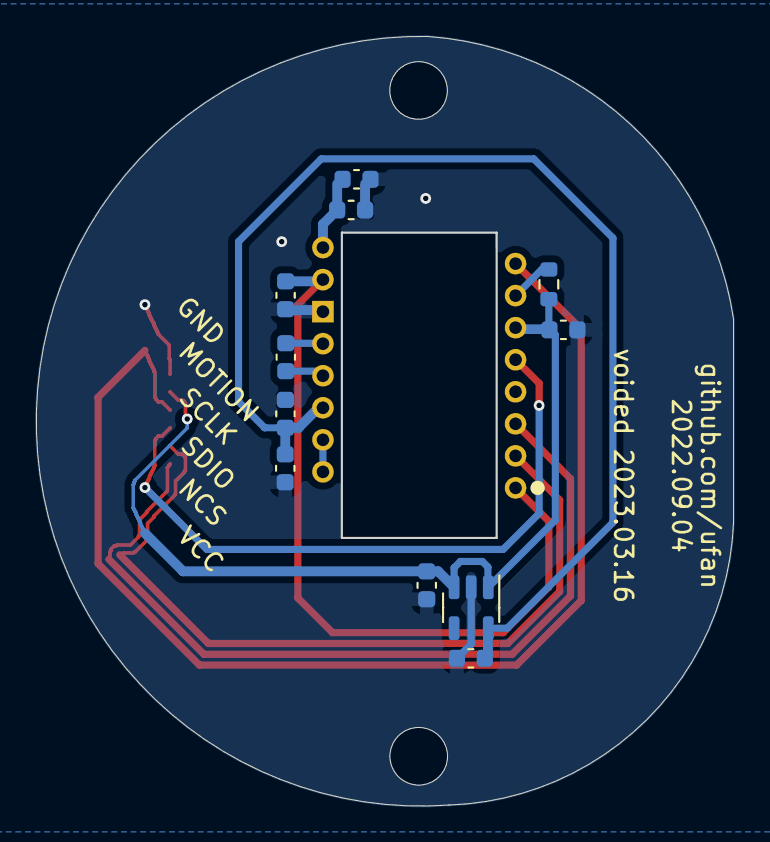
[picture p82: board GyreNanoSensor.kicad_pcb from below]

Board: 2 copper layers, 38.7 x 42.8 mm, 15 parts (12 on the bottom side), 13 nets.
