GavynDracula/GyreNano/(commit log)

2026-11-10 Preserve GyreNano enclosure development snapshot
    Publish right upper V11, left upper and trays V7, exact-mesh 3MF prints, fit trials and bilingual documentation. Include geometry verification and modeling sources while excluding local archives, generated exports and caches.
    [assembly.scad, ball-mount-core.stl, ball-opening-v11.stl, ball-opening-v9.stl, ball34-check-v10.stl, ball35p2-sweep-v10.step, ball35p2-sweep-v10.stl, gyre-nano-left-bottom-v7.3mf]
2026-11-13 Organize PCB sample delivery and preserve engineering snapshot
    [BOM.csv, GyreNanoHolderLeftV12.kicad_pcb, GyreNanoHolderLeftV12.kicad_sch, GyreNanoHolderRightV12.kicad_pcb, GyreNanoHolderRightV12.kicad_sch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]
2026-11-13 Consolidate root into delivery docs and development directories
    [assembly.scad, ball-mount-core.stl, ball-opening-v11.stl, ball-opening-v9.stl, ball34-check-v10.stl, ball35p2-sweep-v10.step, ball35p2-sweep-v10.stl, holder-panel.step]
2026-11-13 Rename print delivery directory to models
    [coupon_gap_15.3mf, coupon_gap_15.stl, coupon_gap_25.3mf, coupon_gap_25.stl, coupon_gap_35.3mf, coupon_gap_35.stl, gyre-nano-left-bottom-v7.3mf, gyre-nano-left-bottom-v7.step]
2026-11-13 Refine enclosure shoulders and round trackball collar
    Add the checked MK2-inspired upper shells, reproducible modeling sources, seam and collar audits, and current previews. Point English and Chinese READMEs to the latest models while retaining earlier enclosure and PCB deliveries. Verified model hashes, exact 3MF packaging, geometry reports, documentation links, and 425 unchanged release files.
    [GyreNanoLeftShell.3mf, GyreNanoRightShell.3mf]
