GavynDracula/GyreNano/(notices)

Notices in the files:
pcb/sensor/upstream/sensor.kicad_sch:
Copyright Quentin Lebastard
